andrewrichardr/MSE3380BGearBoxProject/Figures/ShaftB_torque_diagram.png

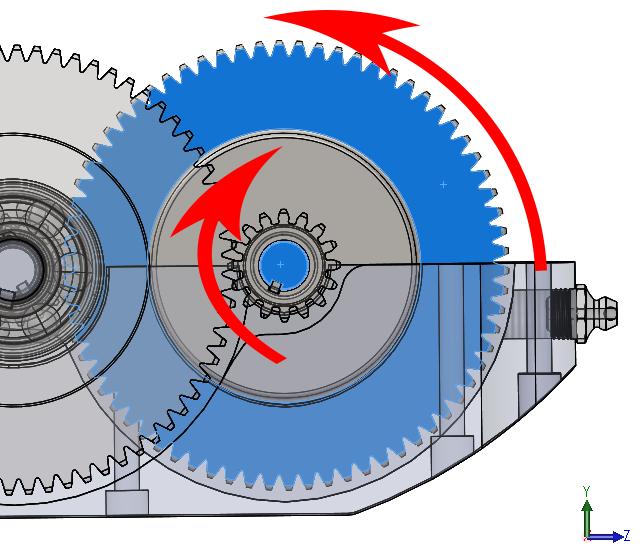
Figures/ShaftB_torque_diagram.png
