andrewrichardr/MSE3380BGearBoxProject/Figures/ShaftC_torque_diagram.png

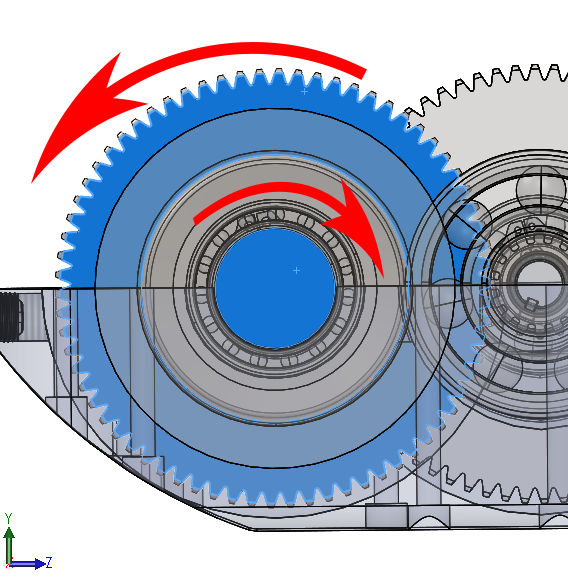
Figures/ShaftC_torque_diagram.png
