andrewrichardr/MSE3380BGearBoxProject/CAD/Drawing.PNG

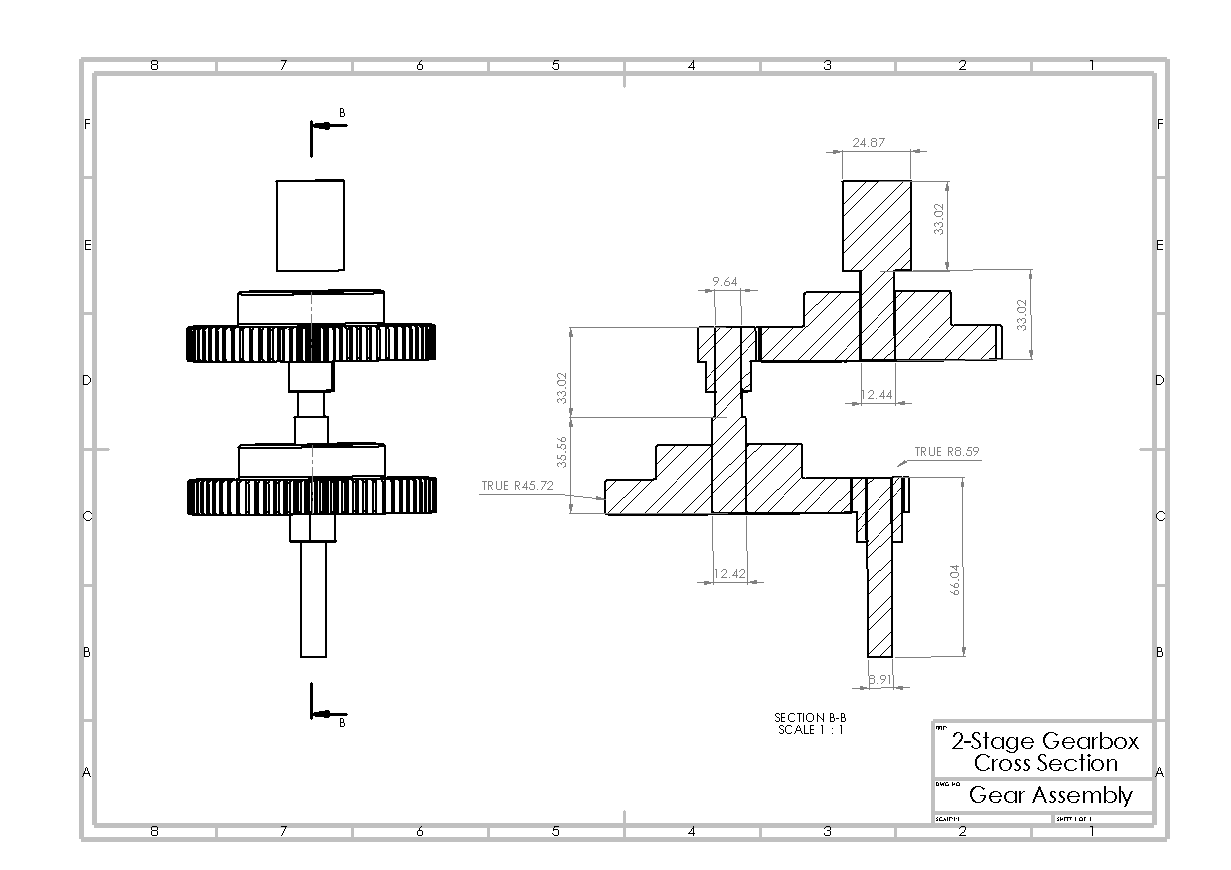
CAD/Drawing.PNG
