andrewrichardr/MSE3380BGearBoxProject/CAD/Part Drawings/Gear_Final.png

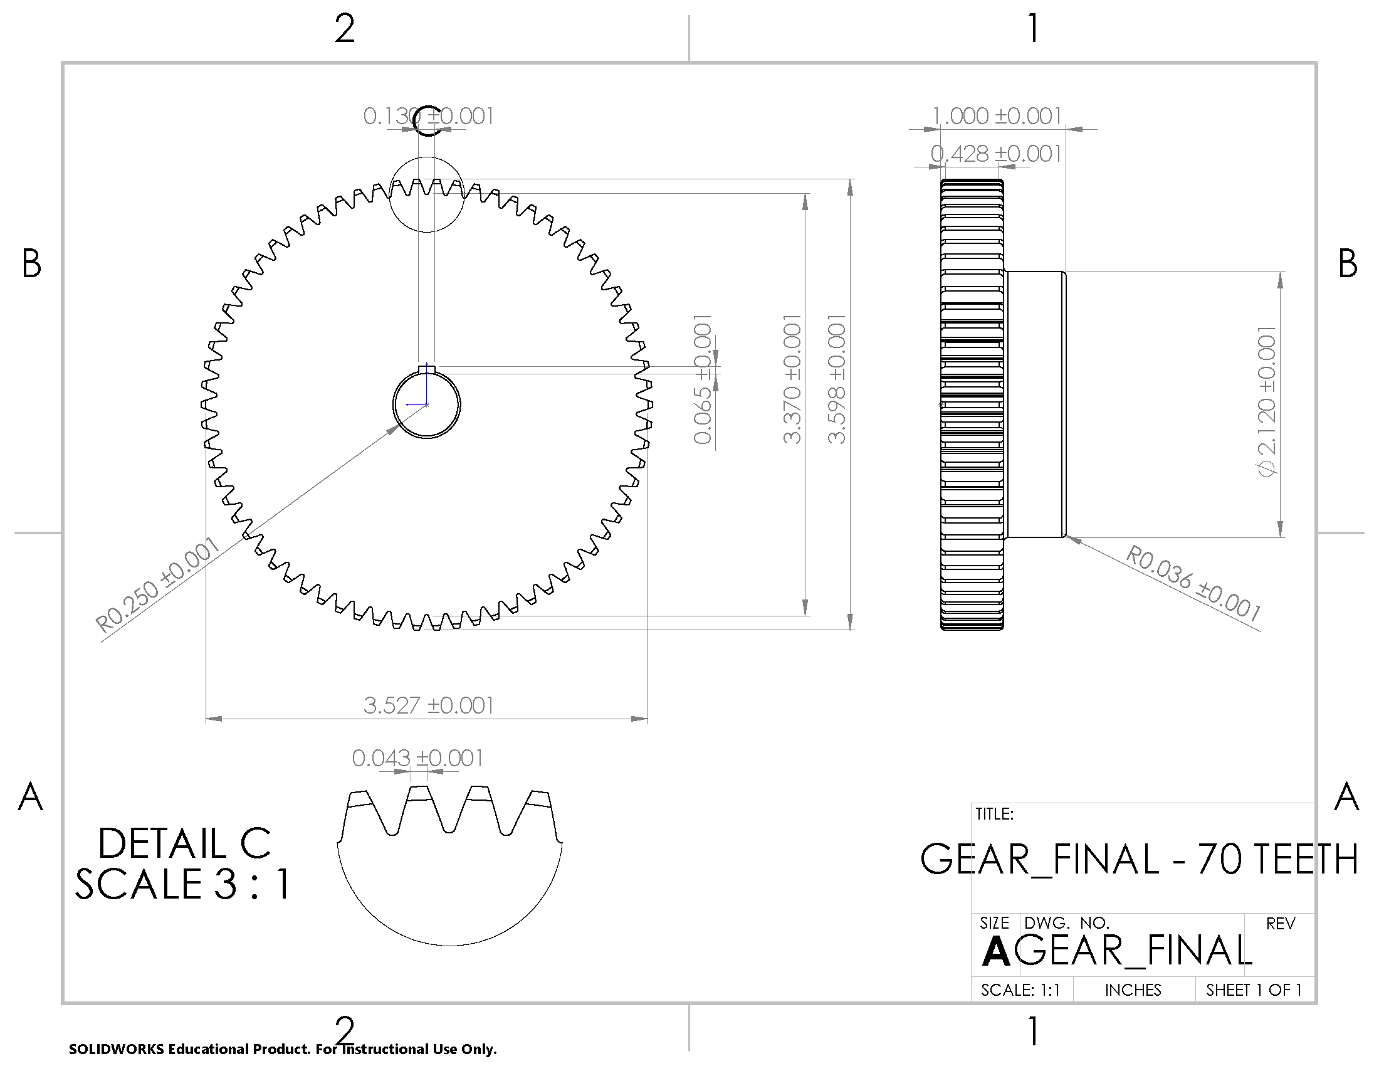
CAD/Part Drawings/Gear_Final.png
