andrewrichardr/MSE3380BGearBoxProject/CAD/Part Drawings/Pinion_Final.png

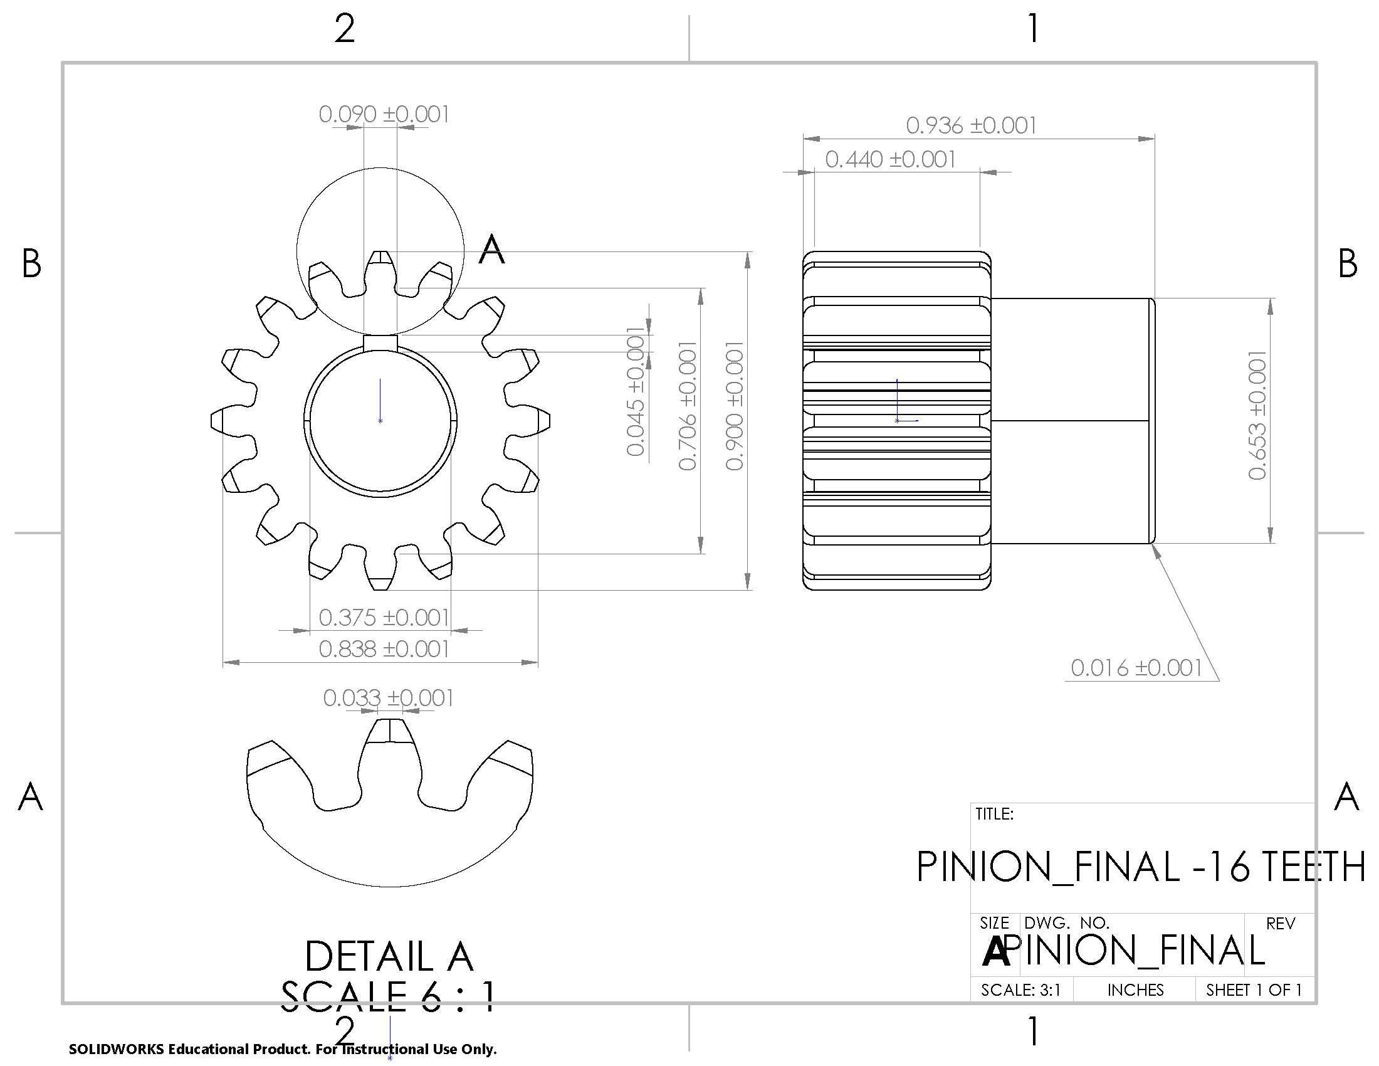
CAD/Part Drawings/Pinion_Final.png
