andrewrichardr/MSE3380BGearBoxProject/CAD/Part Drawings/shaft_A.png

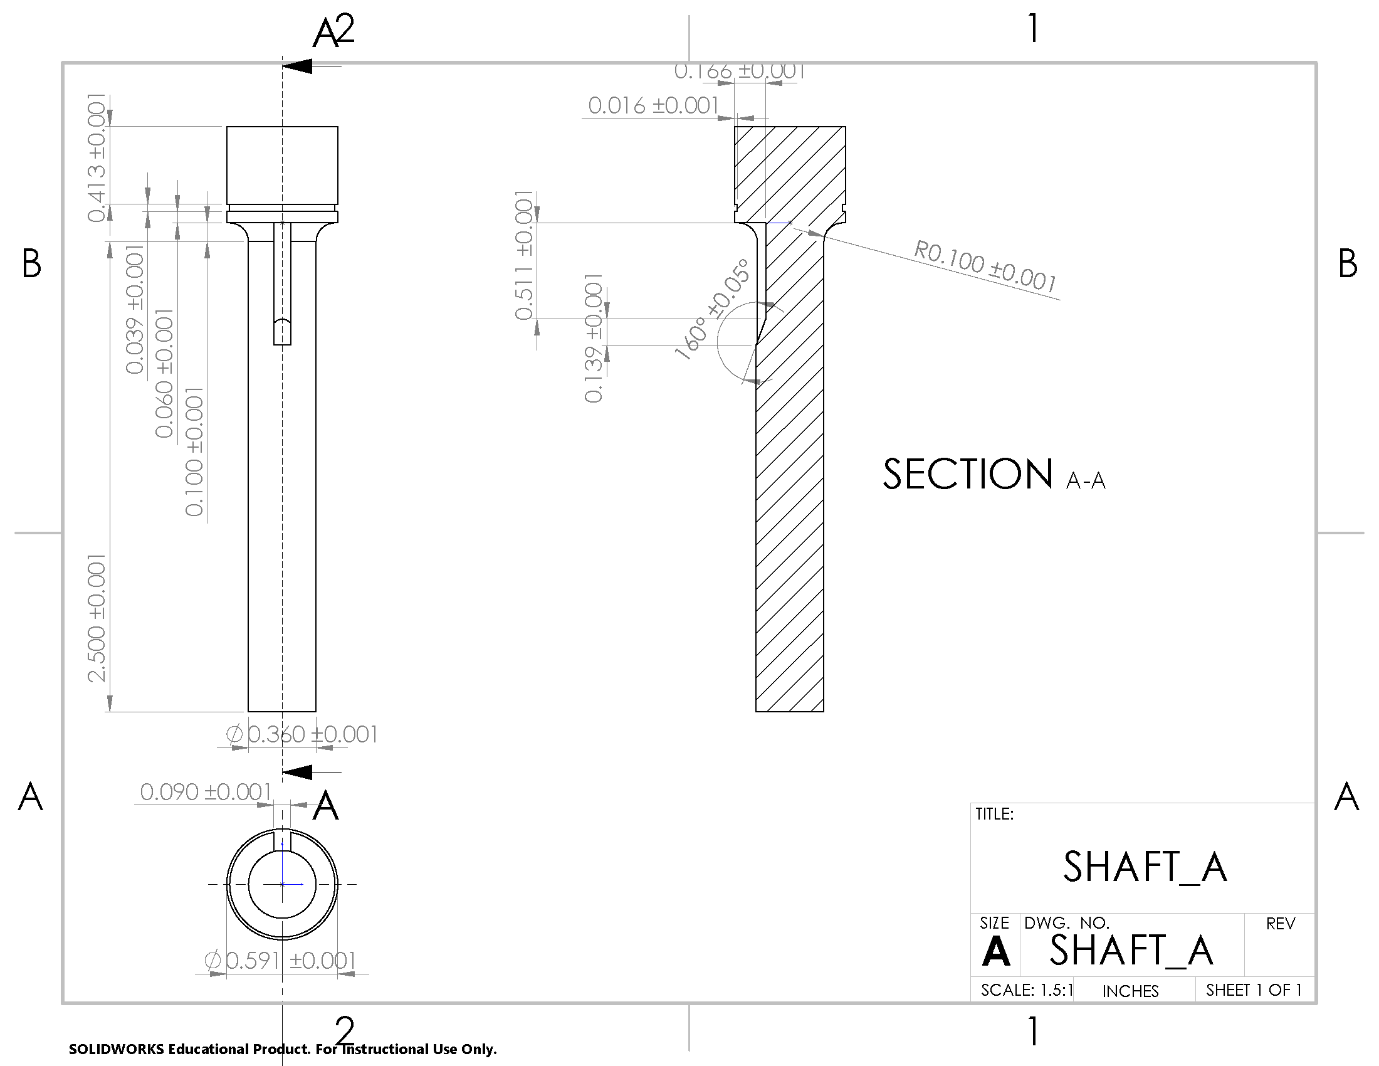
CAD/Part Drawings/shaft_A.png
