andrewrichardr/MSE3380BGearBoxProject/CAD/Part Drawings/shaft_B.png

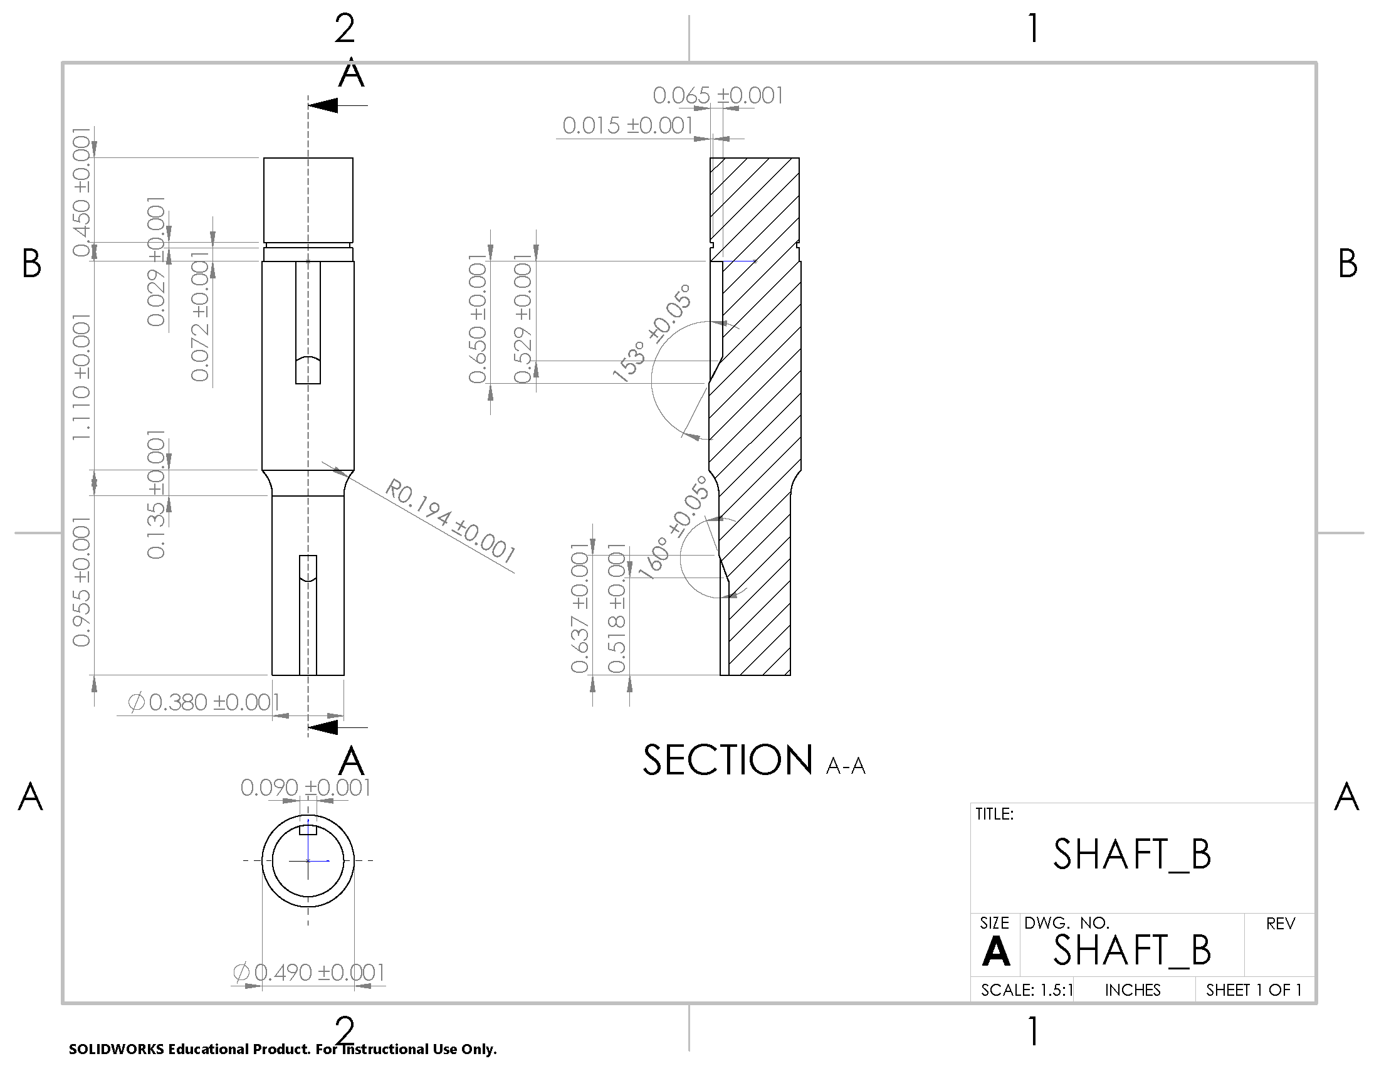
CAD/Part Drawings/shaft_B.png
