andrewrichardr/MSE3380BGearBoxProject/CAD/Part Drawings/Shaft_C.png

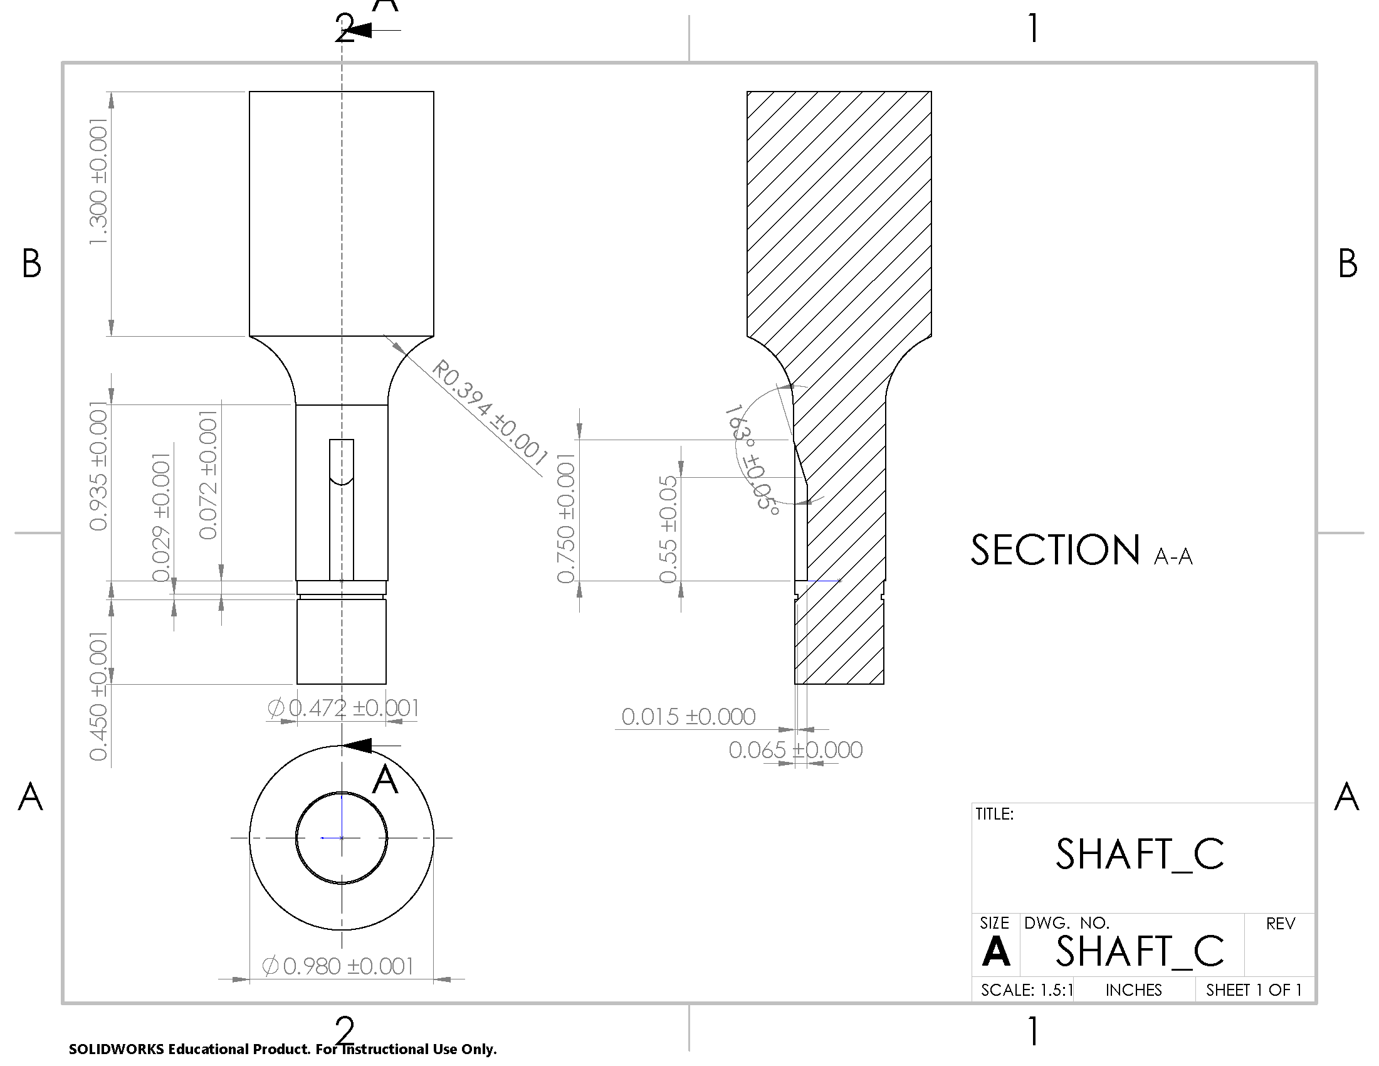
CAD/Part Drawings/Shaft_C.png
