andrewrichardr/MSE3380BGearBoxProject/CAD/retaining rings/groove4.PNG

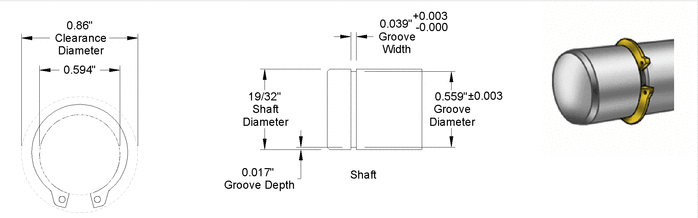
CAD/retaining rings/groove4.PNG
