andrewrichardr/MSE3380BGearBoxProject/CAD/retaining rings/groove13.PNG

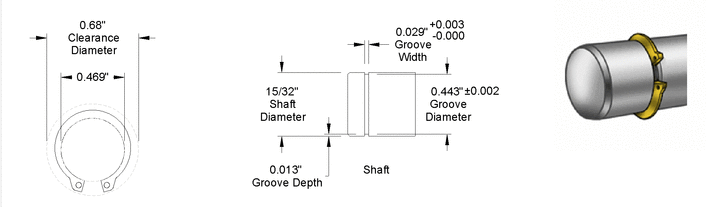
CAD/retaining rings/groove13.PNG
