andrewrichardr/MSE3380BGearBoxProject/Figures/Interim/3D_Model_Placeholder.png

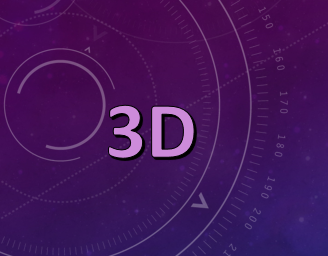
Figures/Interim/3D_Model_Placeholder.png
