andrewrichardr/MSE3380BGearBoxProject/Figures/Interim/contactForces.jpg

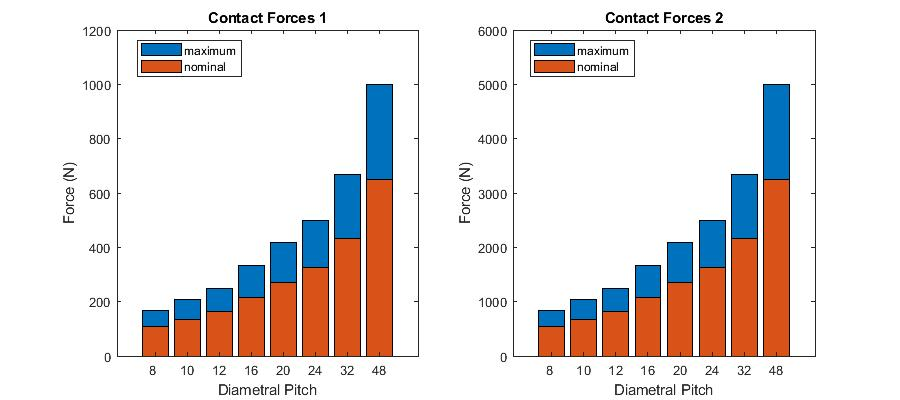
Figures/Interim/contactForces.jpg
