andrewrichardr/MSE3380BGearBoxProject/Figures/Interim/drawings.png

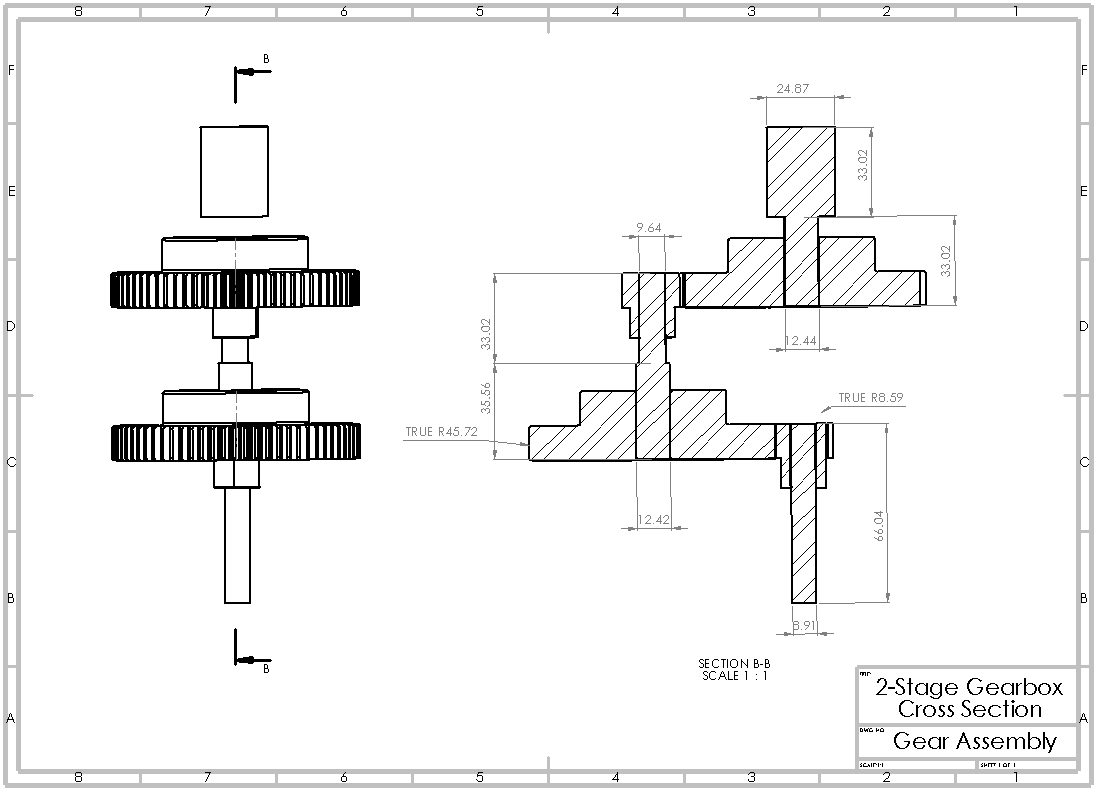
Figures/Interim/drawings.png
