andrewrichardr/MSE3380BGearBoxProject/Figures/Interim/fbd_pinion2_gear2.PNG

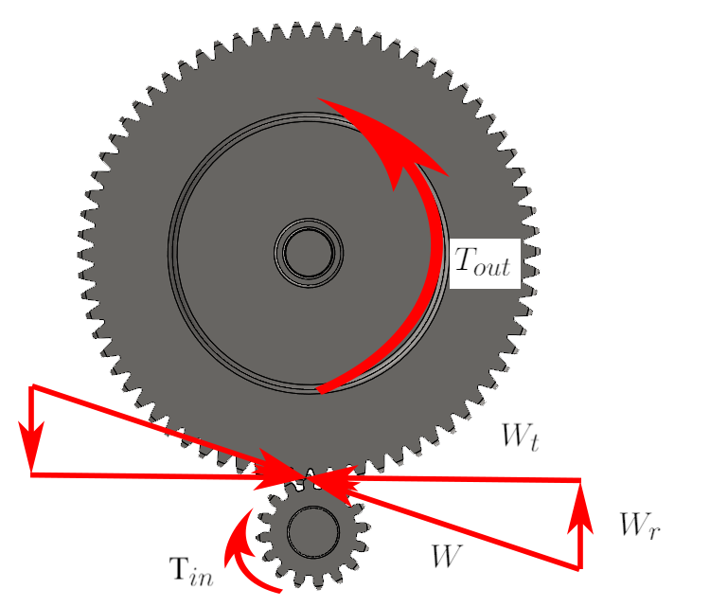
Figures/Interim/fbd_pinion2_gear2.PNG
