andrewrichardr/MSE3380BGearBoxProject/Figures/Interim/Gear.png

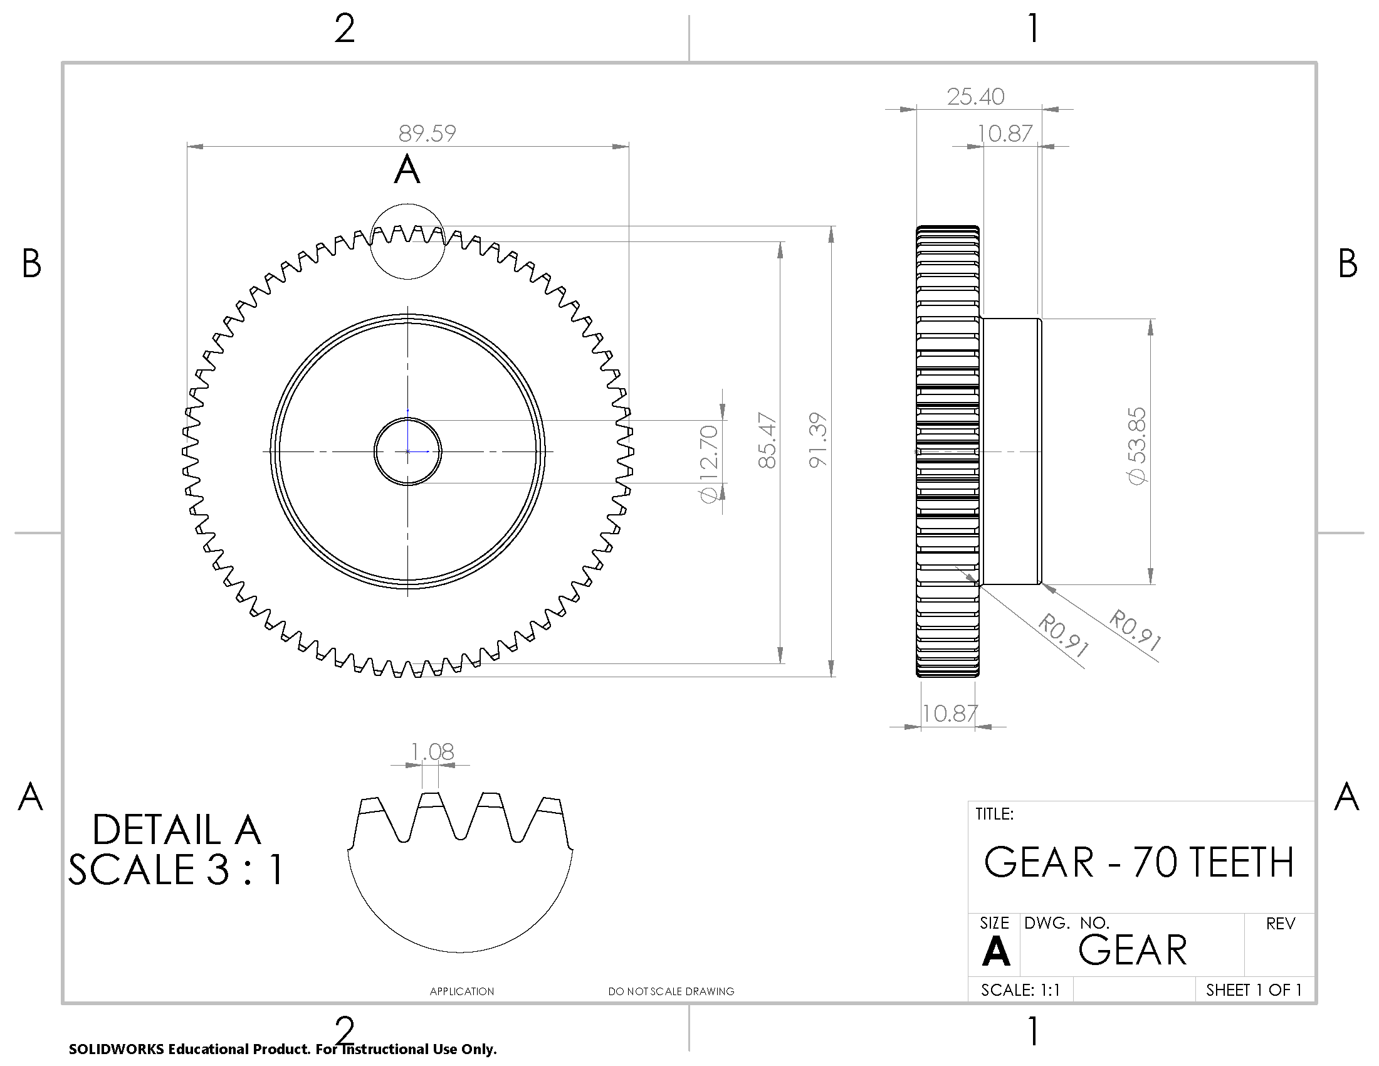
Figures/Interim/Gear.png
