andrewrichardr/MSE3380BGearBoxProject/Figures/Interim/gear_pinion_forces_2d-Recovered.png

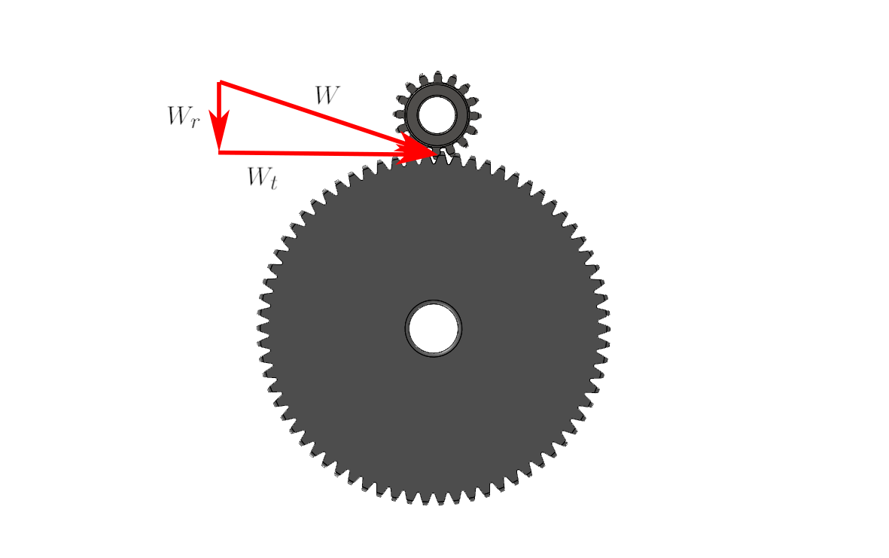
Figures/Interim/gear_pinion_forces_2d-Recovered.png
