andrewrichardr/MSE3380BGearBoxProject/Figures/Interim/gearbox.png

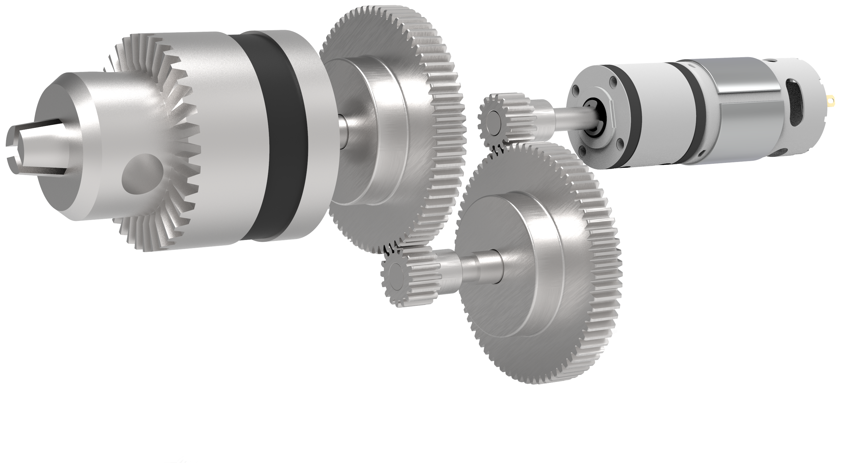
Figures/Interim/gearbox.png
