andrewrichardr/MSE3380BGearBoxProject/Figures/Interim/Pinion.png

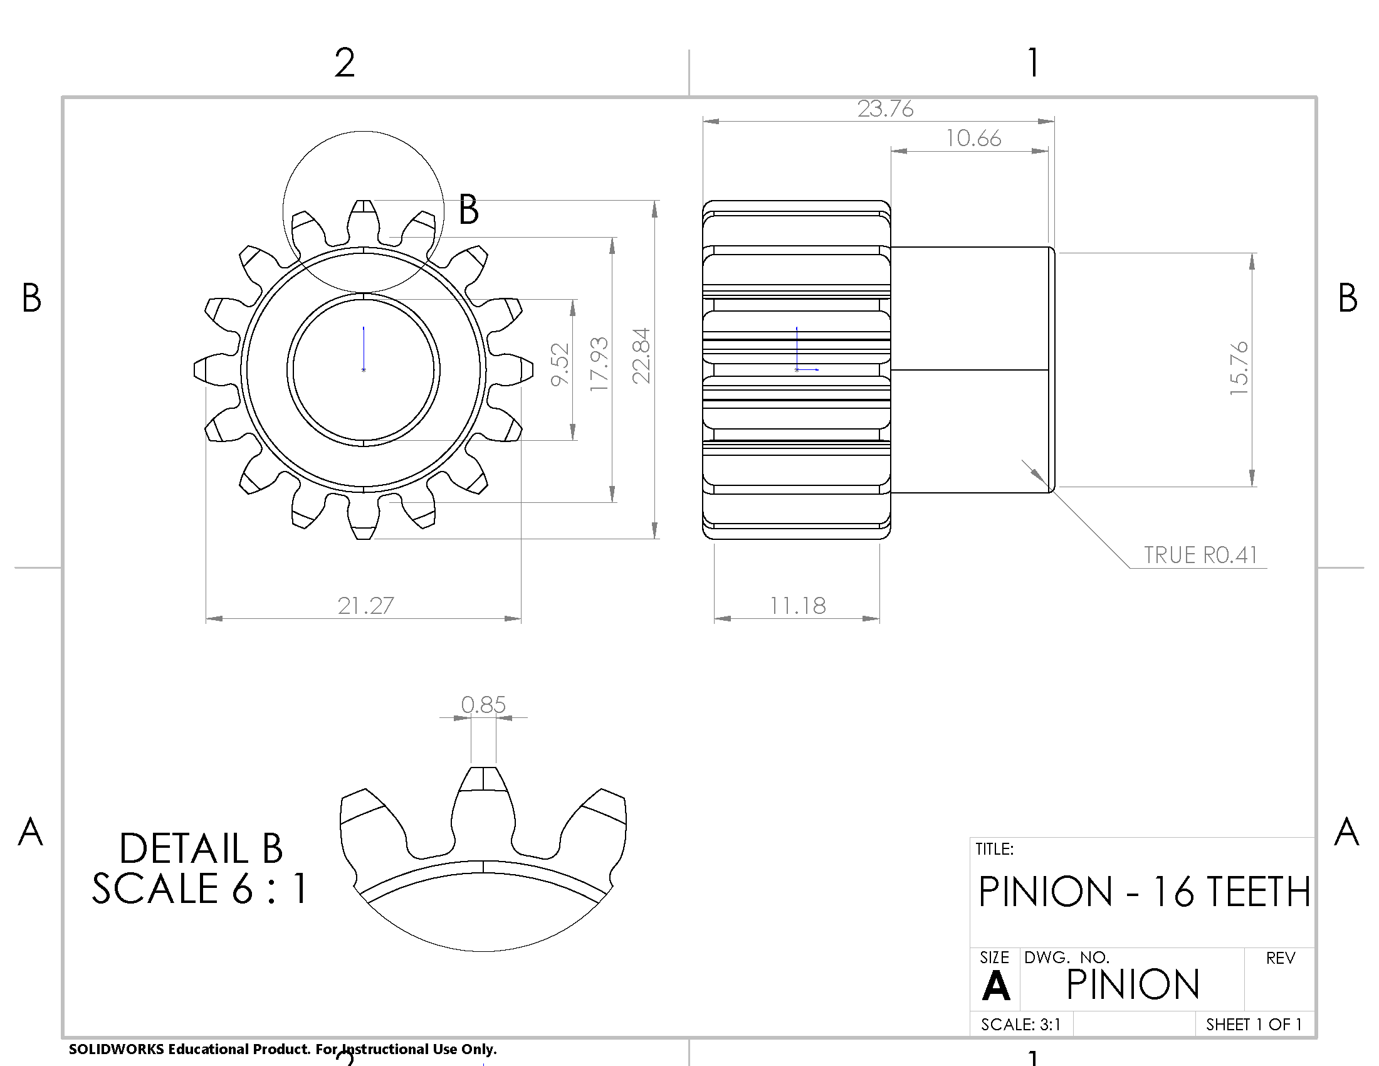
Figures/Interim/Pinion.png
