andrewrichardr/MSE3380BGearBoxProject/Figures/Interim/torque.jpg

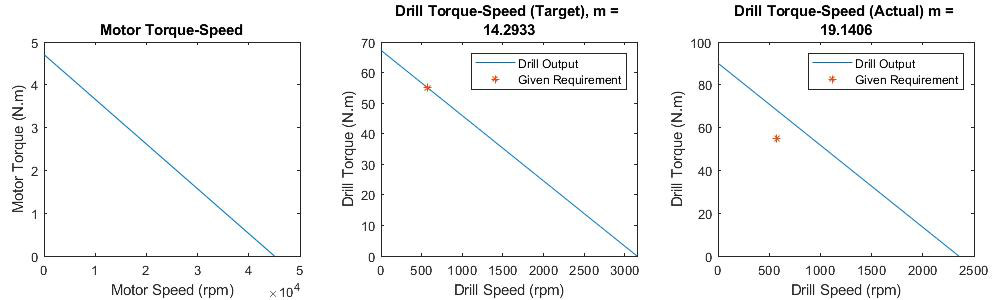
Figures/Interim/torque.jpg
