andrewrichardr/MSE3380BGearBoxProject/Figures/Interim/TorqueSpeed.jpg

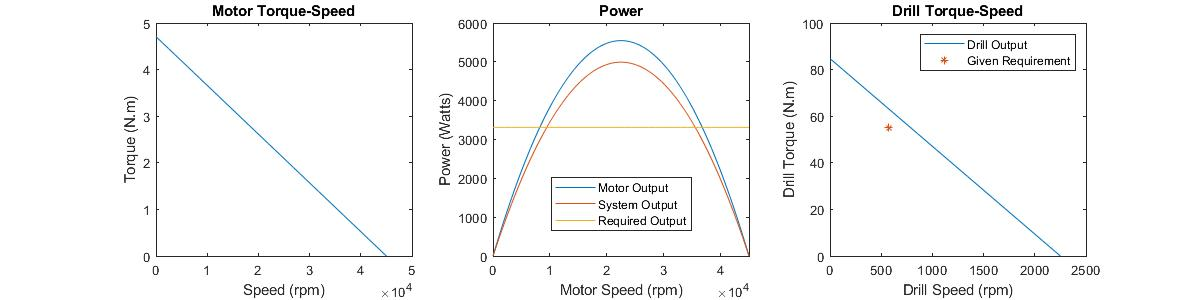
Figures/Interim/TorqueSpeed.jpg
