andrewrichardr/MSE3380BGearBoxProject/Figures/SBT_A.jpg

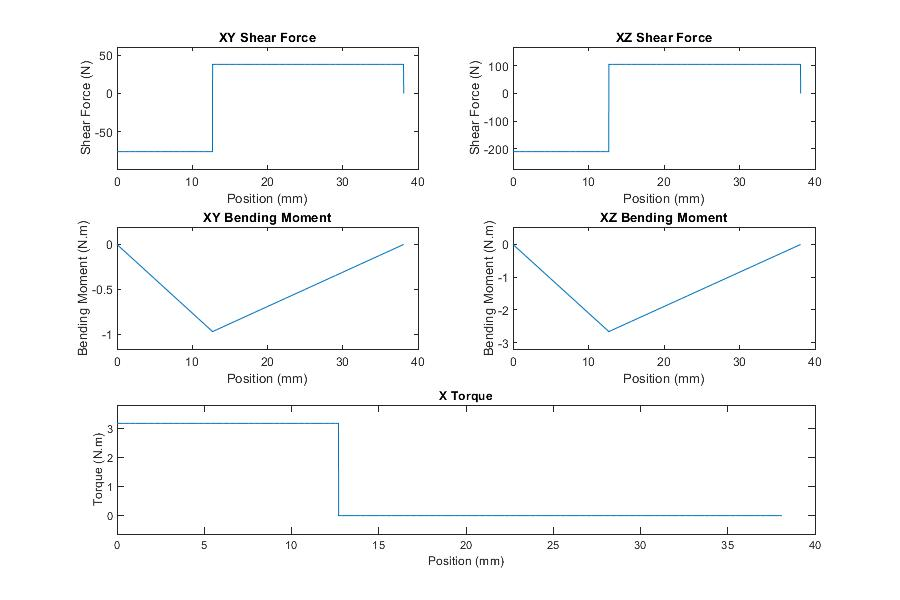
Figures/SBT_A.jpg
