andrewrichardr/MSE3380BGearBoxProject/Figures/SBT_C.jpg

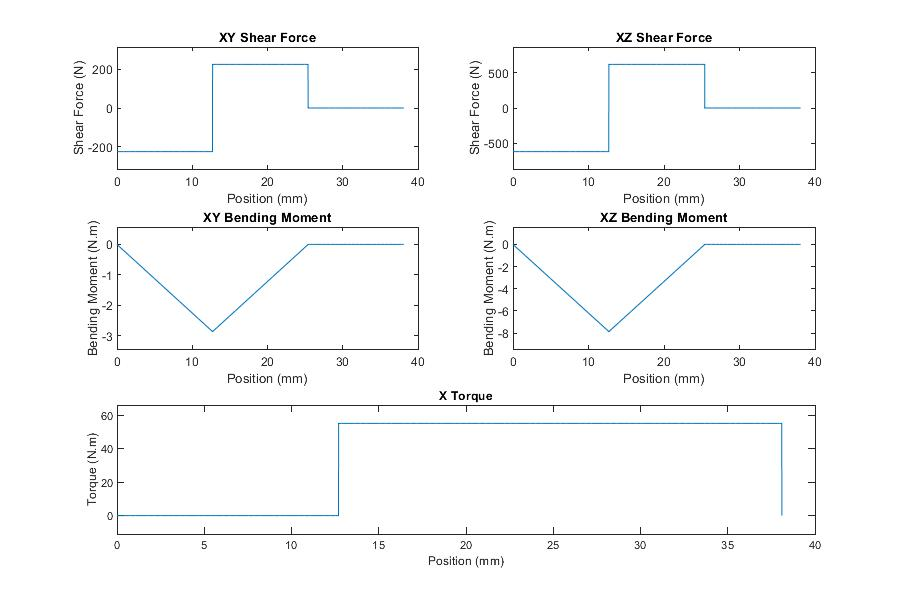
Figures/SBT_C.jpg
