andrewrichardr/MSE3380BGearBoxProject/Figures/ShaftA_clear.PNG

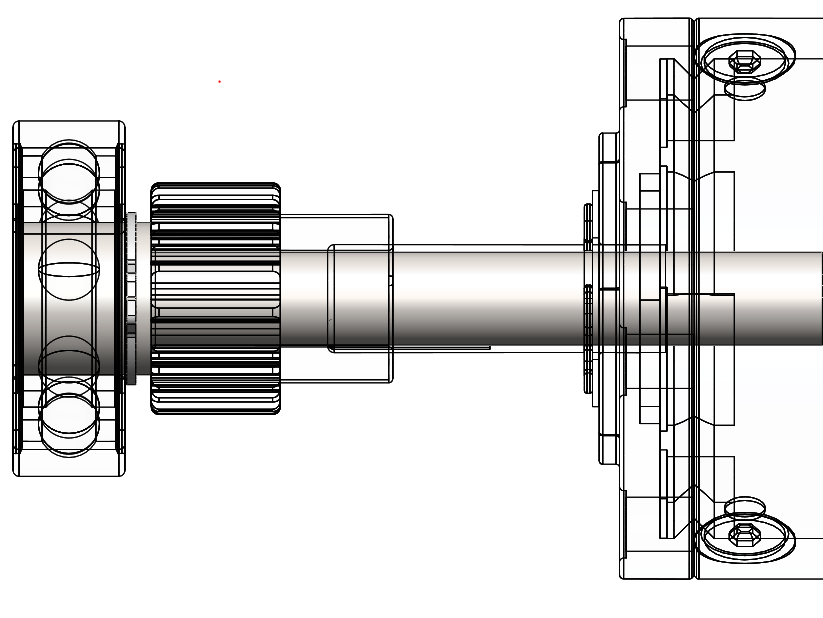
Figures/ShaftA_clear.PNG
