andrewrichardr/MSE3380BGearBoxProject/Figures/ShaftA_torque_diagram.png

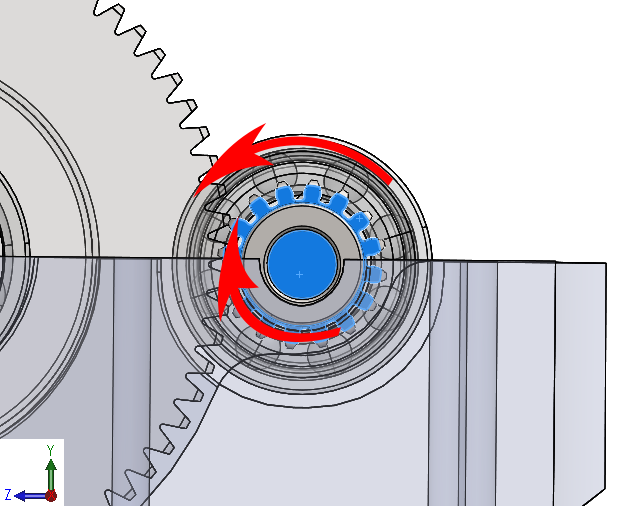
Figures/ShaftA_torque_diagram.png
