andrewrichardr/MSE3380BGearBoxProject/Figures/ShaftA_XY_FBD.png

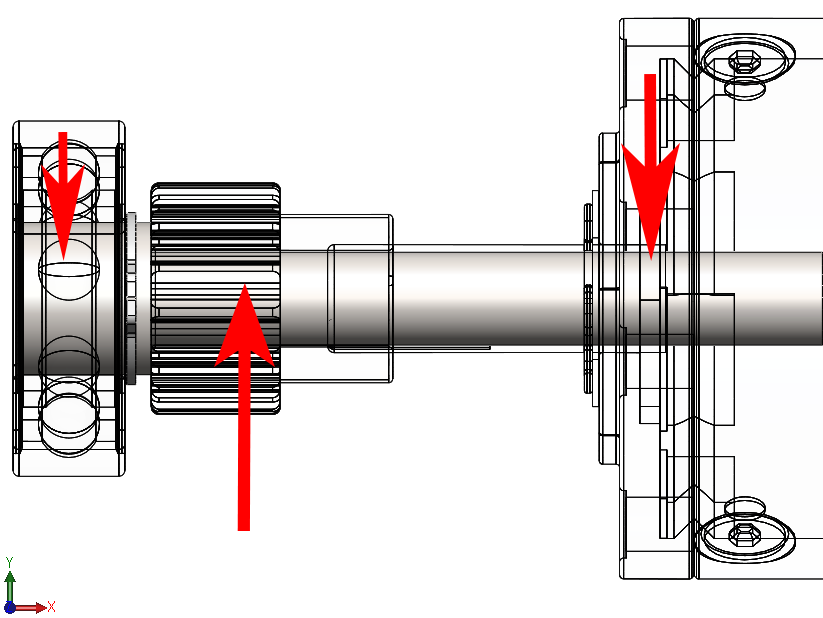
Figures/ShaftA_XY_FBD.png
