andrewrichardr/MSE3380BGearBoxProject/Figures/ShaftB_clear.PNG

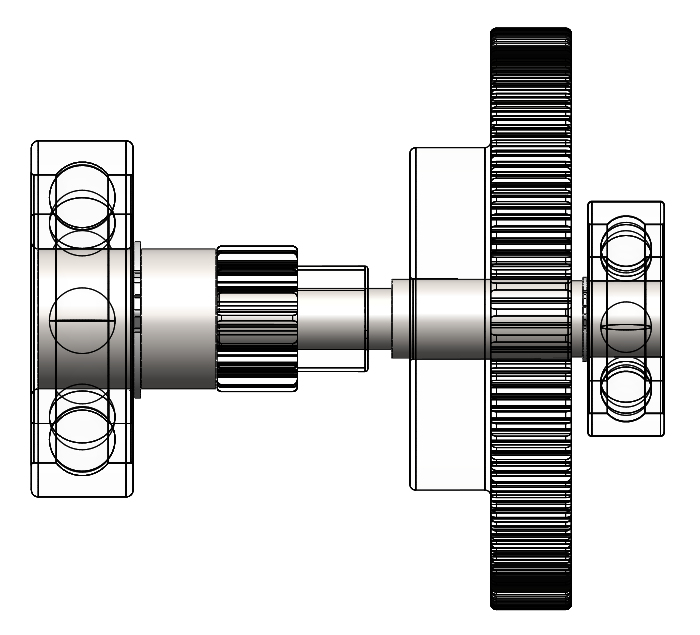
Figures/ShaftB_clear.PNG
