andrewrichardr/MSE3380BGearBoxProject/Figures/ShaftB_torque_diagram_clean.PNG

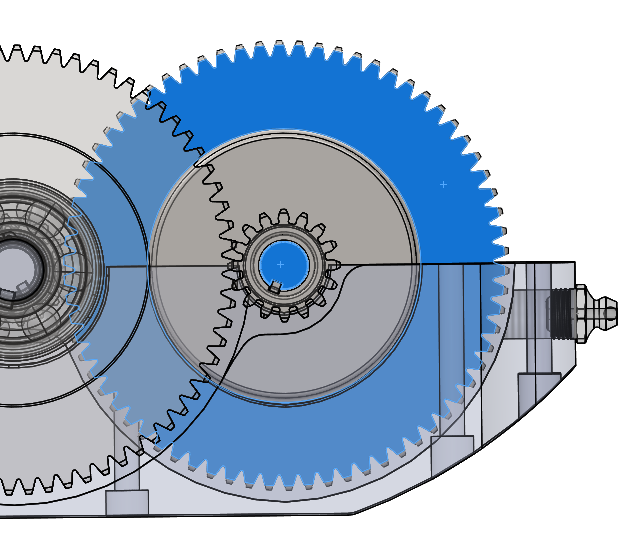
Figures/ShaftB_torque_diagram_clean.PNG
