andrewrichardr/MSE3380BGearBoxProject/Figures/ShaftB_XY_FBD.png

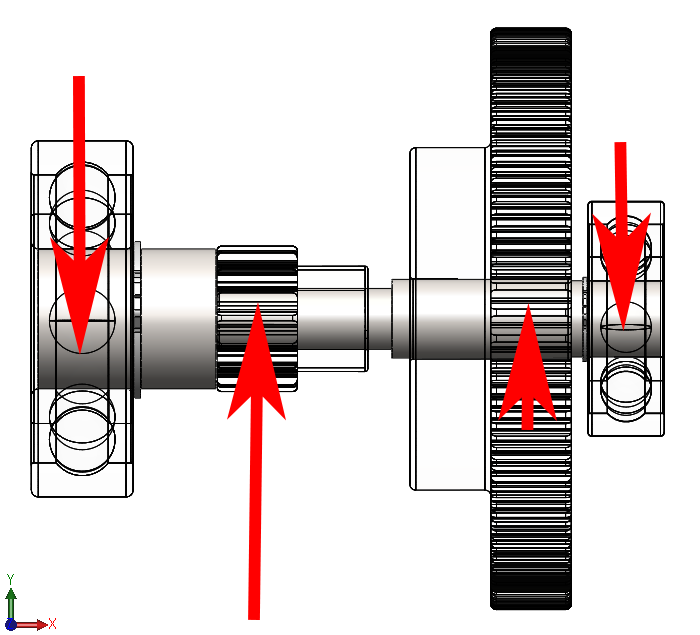
Figures/ShaftB_XY_FBD.png
