andrewrichardr/MSE3380BGearBoxProject/Figures/ShaftC_clear.PNG

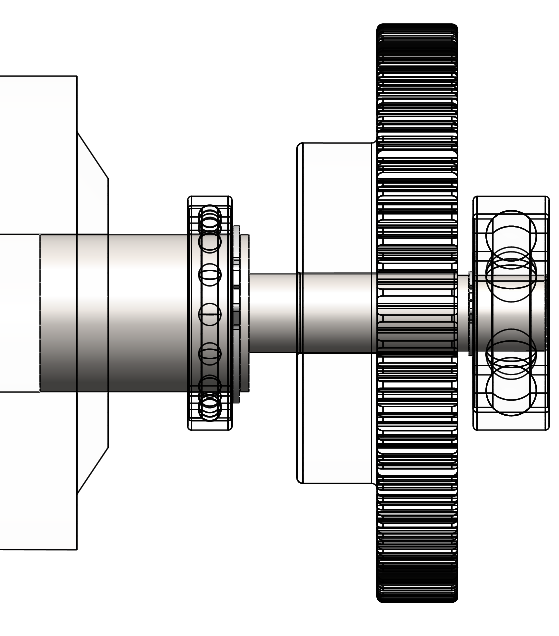
Figures/ShaftC_clear.PNG
