andrewrichardr/MSE3380BGearBoxProject/CAD/AssemblyWithMotor/6301.sldasm

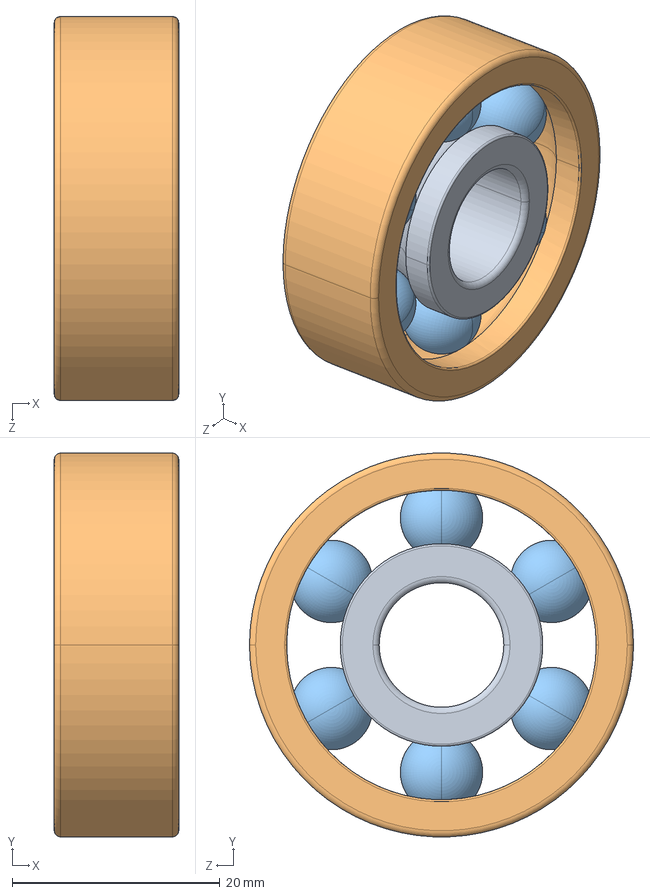
[picture p39: CAD file, 2019-04-09]
CAD/AssemblyWithMotor/6301.sldasm
12.0 x 37.0 x 37.0 mm
_6301_PART1_2
_6301_PART2_4
_6301_PART3_6 x 6
