andrewrichardr/MSE3380BGearBoxProject/CAD/AssemblyWithMotor/AssemblyWithMotor.SLDASM

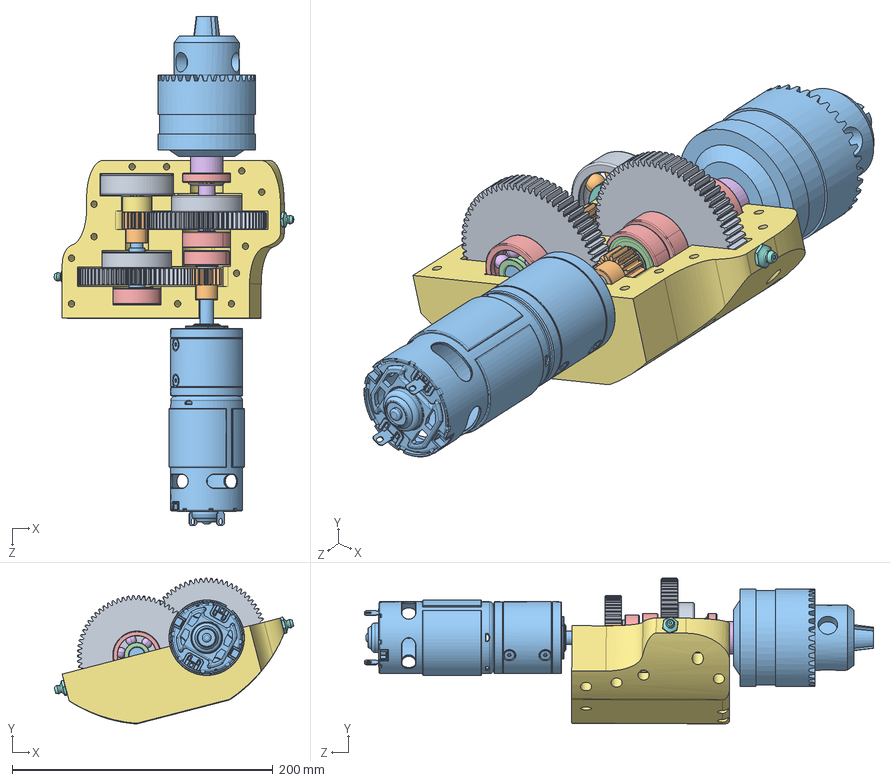
[picture p40: CAD file, 2019-04-09]
CAD/AssemblyWithMotor/AssemblyWithMotor.SLDASM
183.6 x 111.8 x 390.2 mm
Gear x 2
Pinion x 2
Chuck
_6202_2RSL_PART1_2
_6202_2RSL_PART2_4
_6202_2RSL_PART3_6 x 8
bearingshaft3
_63_22_PART1_2
_63_22_PART2_4
_63_22_PART3_6 x 7
bearingshaft4
_6301_PART1_2 x 2
_6301_PART2_4 x 2
_6301_PART3_6 x 12
housing
Bearing13 x 2
Bearing2
bearing4
motorDC
_61805_PART1_2
_61805_PART2_4
_61805_PART3_6 x 15
NEWRING
1095K650_STEEL GREASE FITTING x 2
shaft_A
keyway_A
shaft_B
keyway_B1
keyway_B2
Shaft_C
keyway_C
