andrewrichardr/MSE3380BGearBoxProject/CAD/Parts/motorDC.SLDASM

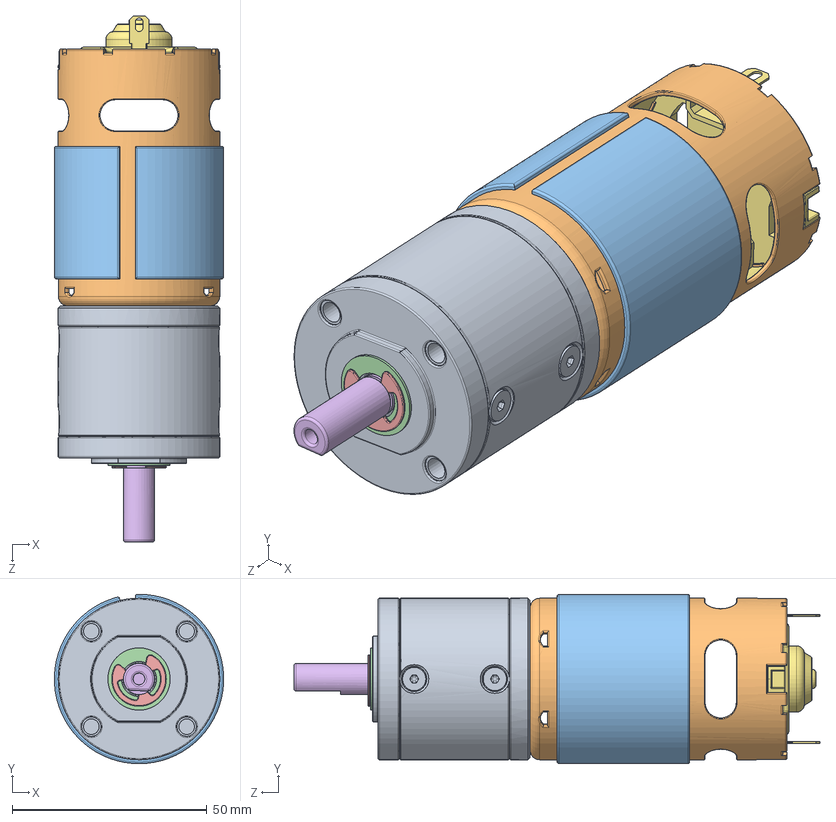
[picture p41: CAD file, 2019-03-22]
CAD/Parts/motorDC.SLDASM
43.5 x 43.5 x 135.1 mm
GearBox_motorDC
Coil_motorDC
Gelung_motorDC
Wessel_motorDC
Lock_motorDC
Shaft_motorDC
Brush_motorDC
