andrewrichardr/MSE3380BGearBoxProject/CAD/Final_Assembly/housing.SLDPRT

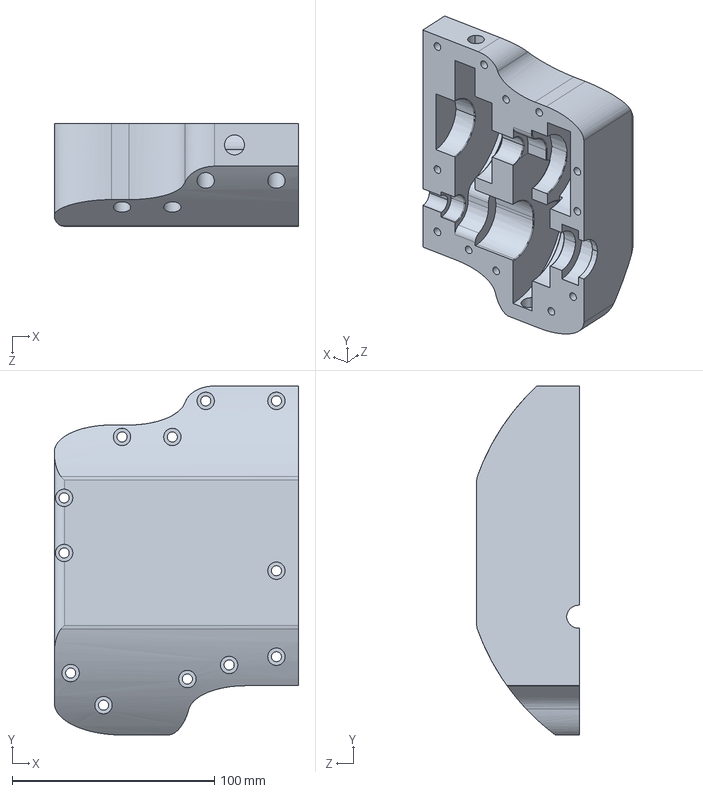
[picture p42: CAD file, 2019-04-09]
CAD/Final_Assembly/housing.SLDPRT
120.9 x 172.7 x 50.8 mm
