andrewrichardr/MSE3380BGearBoxProject/CAD/NEWRING.SLDPRT

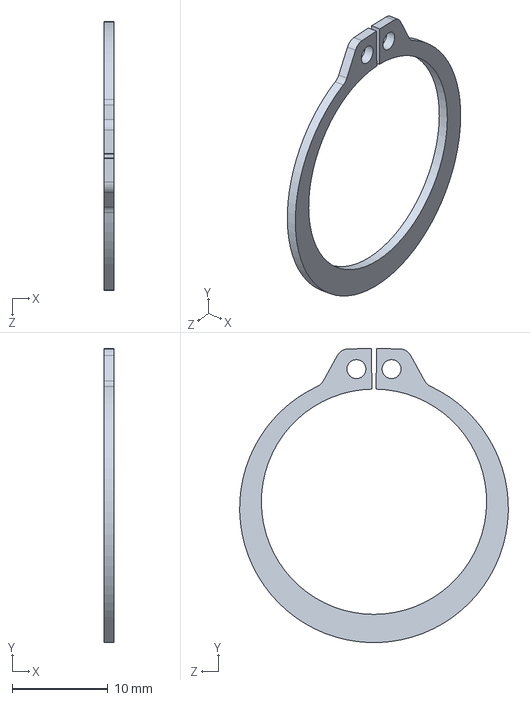
[picture p43: CAD file, 2019-04-09]
CAD/NEWRING.SLDPRT
1.07 x 30.7 x 28.0 mm
