andrewrichardr/MSE3380BGearBoxProject/CAD/Parts/Lock_motorDC.SLDPRT

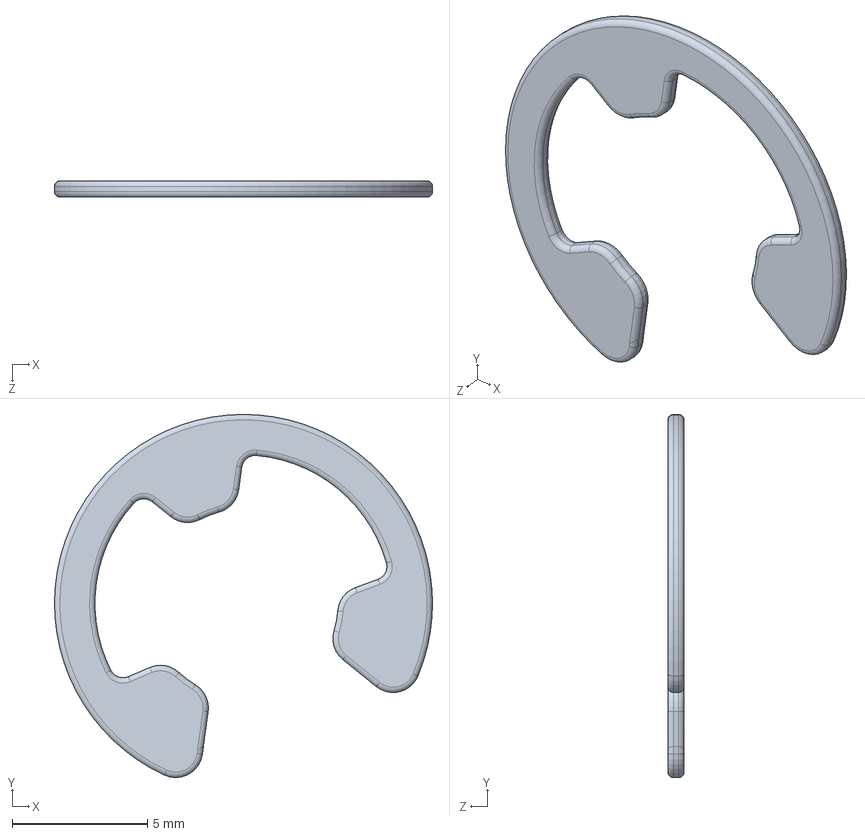
[picture p44: CAD file, 2019-03-22]
CAD/Parts/Lock_motorDC.SLDPRT
14.0 x 13.4 x 0.6 mm
