andrewrichardr/MSE3380BGearBoxProject/CAD/retaining rings/Bearing13.SLDPRT

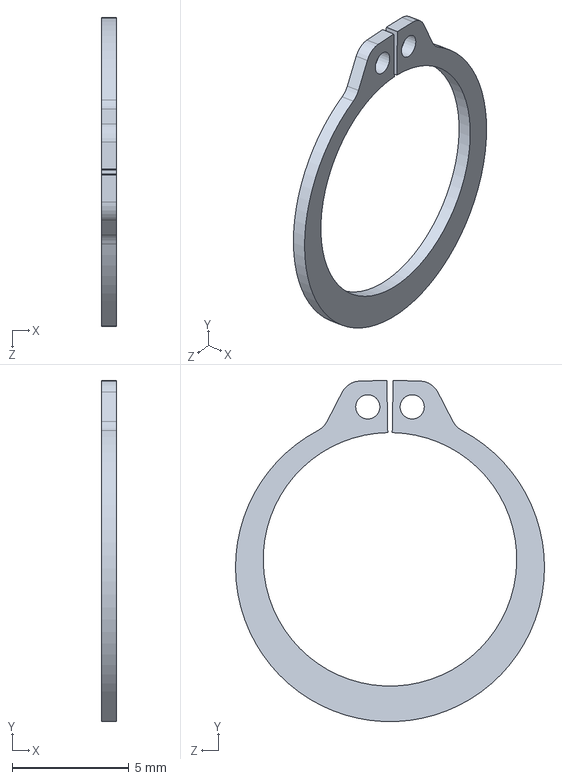
[picture p45: CAD file, 2019-04-08]
CAD/retaining rings/Bearing13.SLDPRT
0.635 x 14.6 x 13.2 mm
