andrewrichardr/MSE3380BGearBoxProject/CAD/Parts/Brush_motorDC.SLDPRT

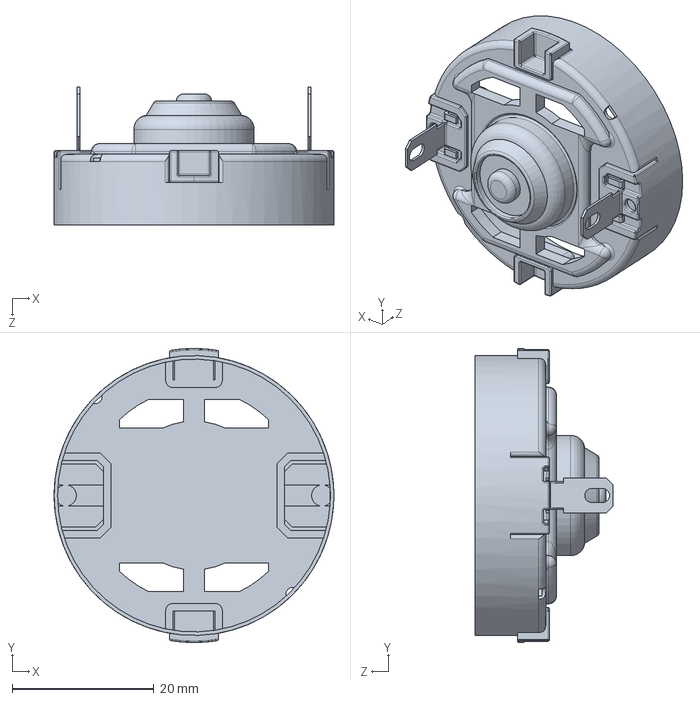
[picture p46: CAD file, 2019-03-22]
CAD/Parts/Brush_motorDC.SLDPRT
39.5 x 41.5 x 19.5 mm
