andrewrichardr/MSE3380BGearBoxProject/CAD/retaining rings/Bearing2.SLDPRT

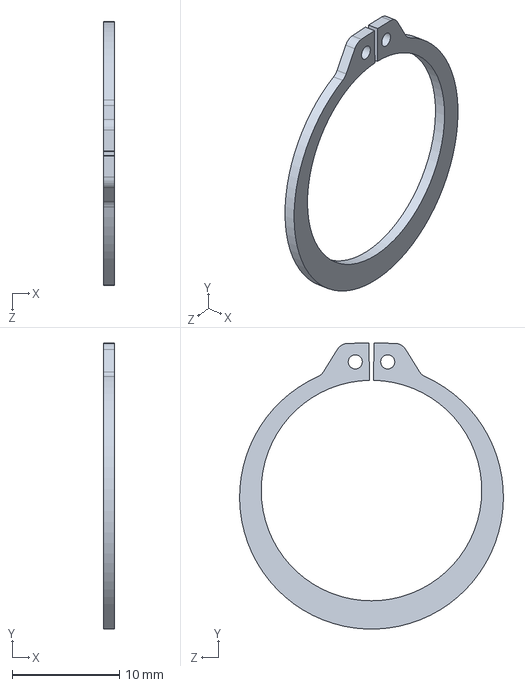
[picture p47: CAD file, 2019-04-08]
CAD/retaining rings/Bearing2.SLDPRT
1.07 x 26.7 x 24.6 mm
