andrewrichardr/MSE3380BGearBoxProject/CAD/Parts/Chuck_Shaft.SLDPRT

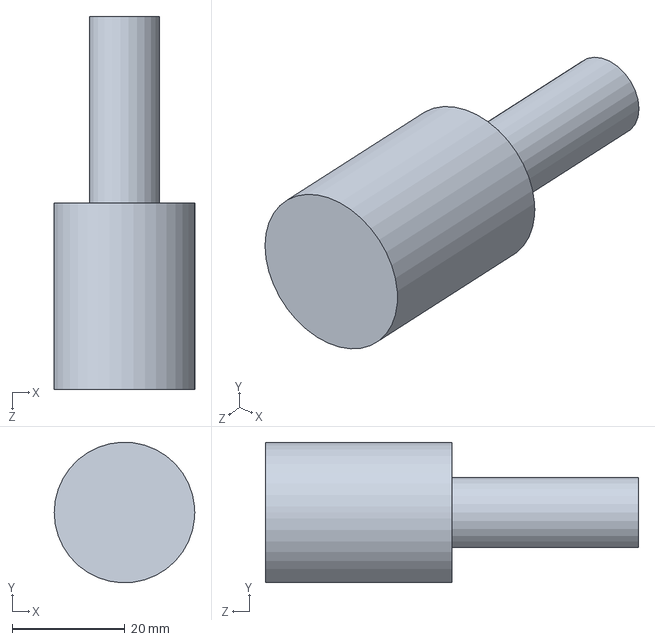
[picture p48: CAD file, 2019-03-22]
CAD/Parts/Chuck_Shaft.SLDPRT
24.9 x 24.9 x 66.0 mm
