andrewrichardr/MSE3380BGearBoxProject/CAD/retaining rings/bearing4.SLDPRT

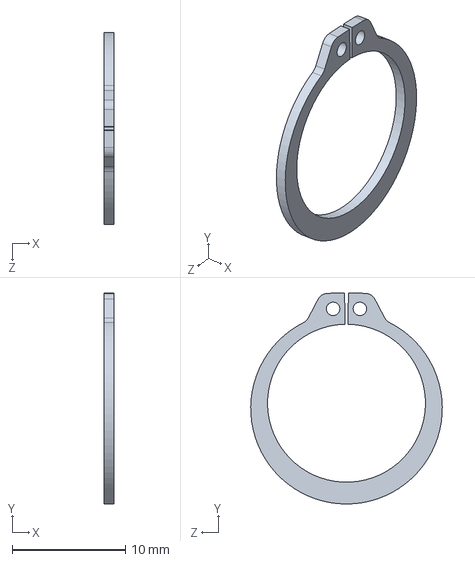
[picture p49: CAD file, 2019-04-08]
CAD/retaining rings/bearing4.SLDPRT
0.889 x 18.7 x 16.9 mm
