andrewrichardr/MSE3380BGearBoxProject/CAD/Final_Assembly/shaft_A.SLDPRT

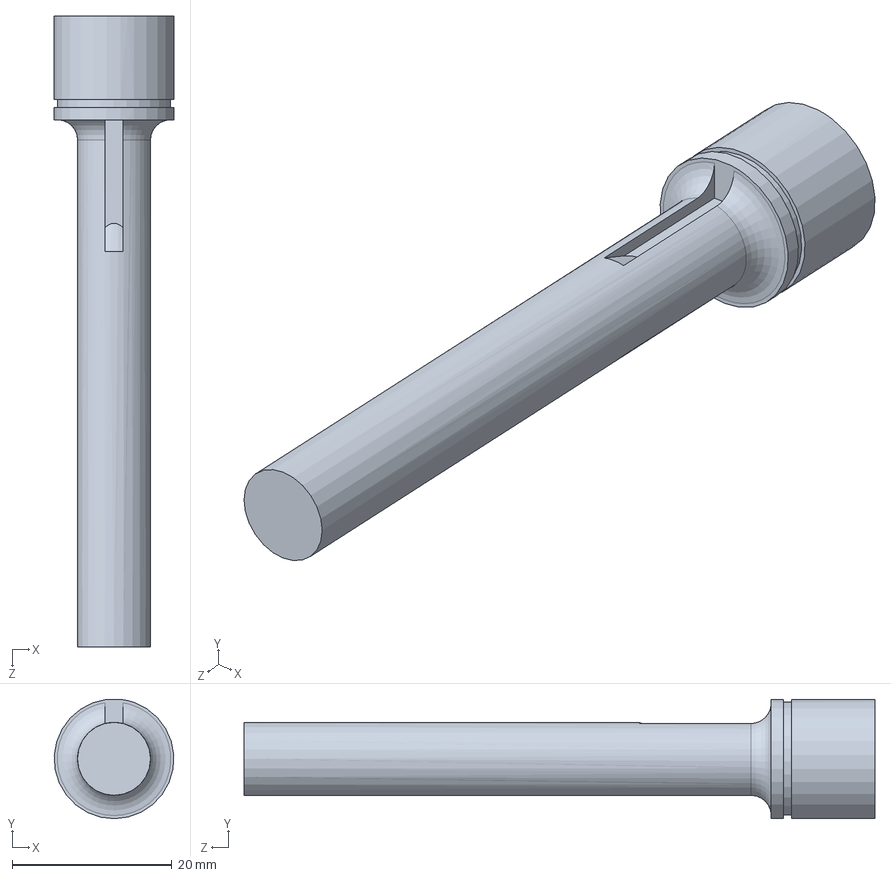
[picture p50: CAD file, 2019-04-09]
CAD/Final_Assembly/shaft_A.SLDPRT
15.0 x 15.0 x 79.0 mm
