andrewrichardr/MSE3380BGearBoxProject/CAD/Parts/Pinion.SLDPRT

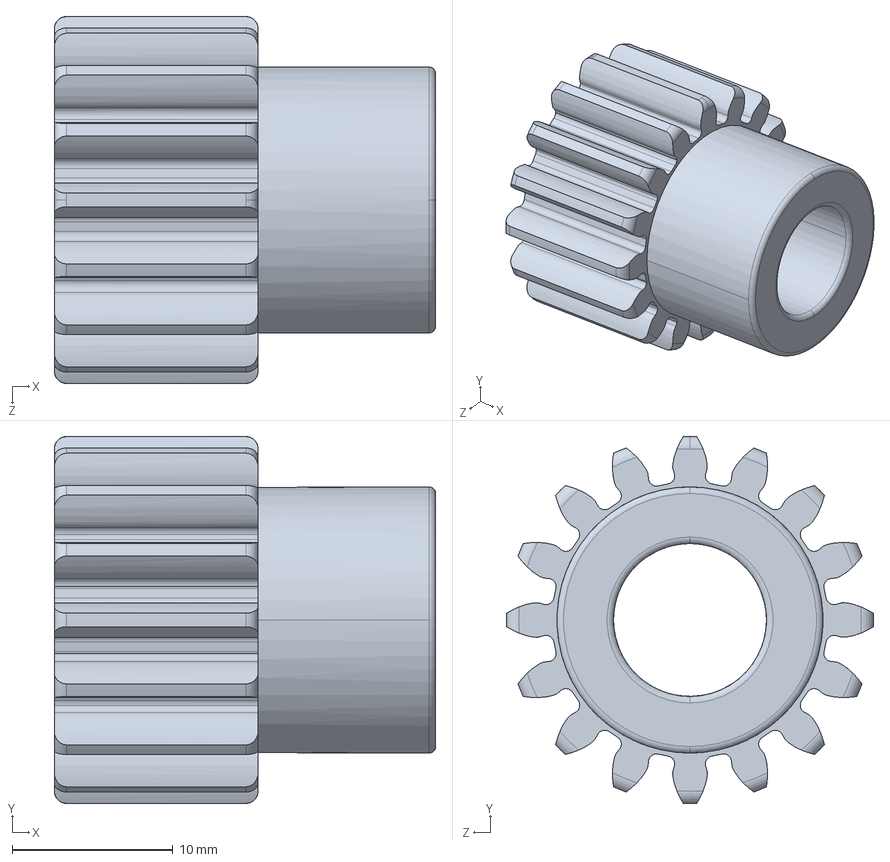
[picture p51: CAD file, 2019-03-22]
CAD/Parts/Pinion.SLDPRT
23.8 x 22.9 x 22.9 mm
