andrewrichardr/MSE3380BGearBoxProject/CAD/AssemblyWithMotor/shaft_B.SLDPRT

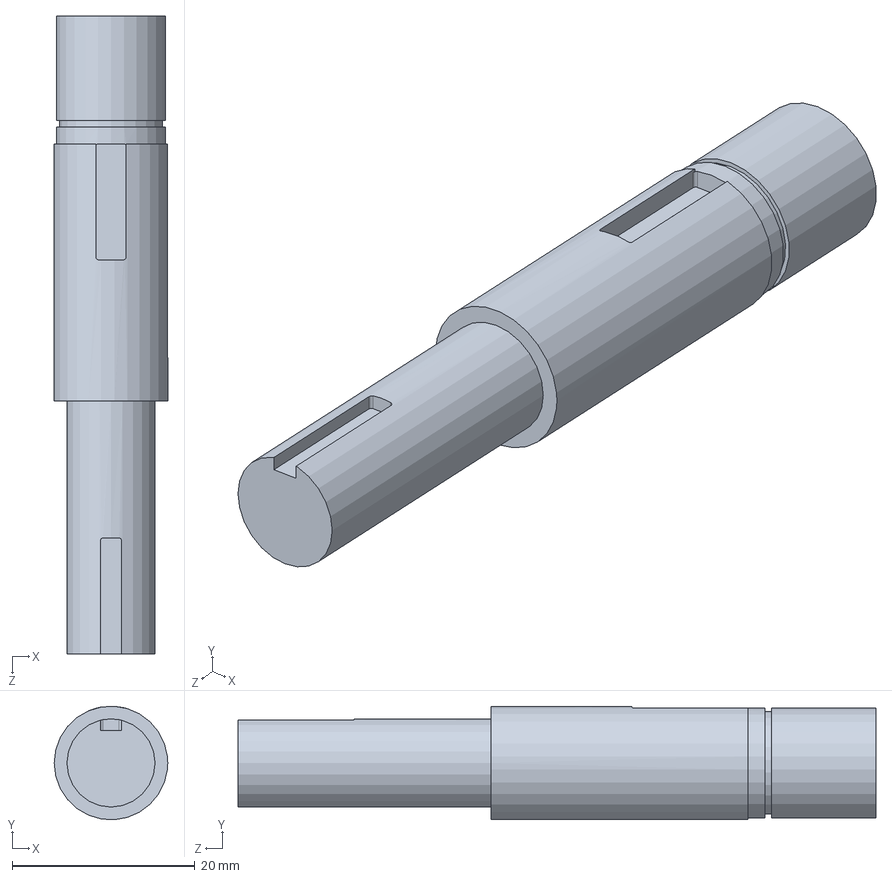
[picture p52: CAD file, 2019-04-09]
CAD/AssemblyWithMotor/shaft_B.SLDPRT
12.4 x 12.4 x 69.9 mm
