andrewrichardr/MSE3380BGearBoxProject/CAD/Final_Assembly/Shaft_C.SLDPRT

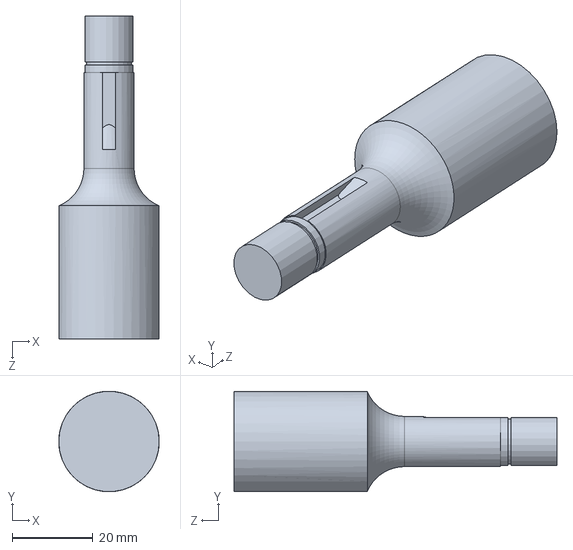
[picture p53: CAD file, 2019-04-09]
CAD/Final_Assembly/Shaft_C.SLDPRT
24.9 x 24.9 x 80.0 mm
