andrewrichardr/MSE3380BGearBoxProject/CAD/Parts/Pinion_Shaft.SLDPRT

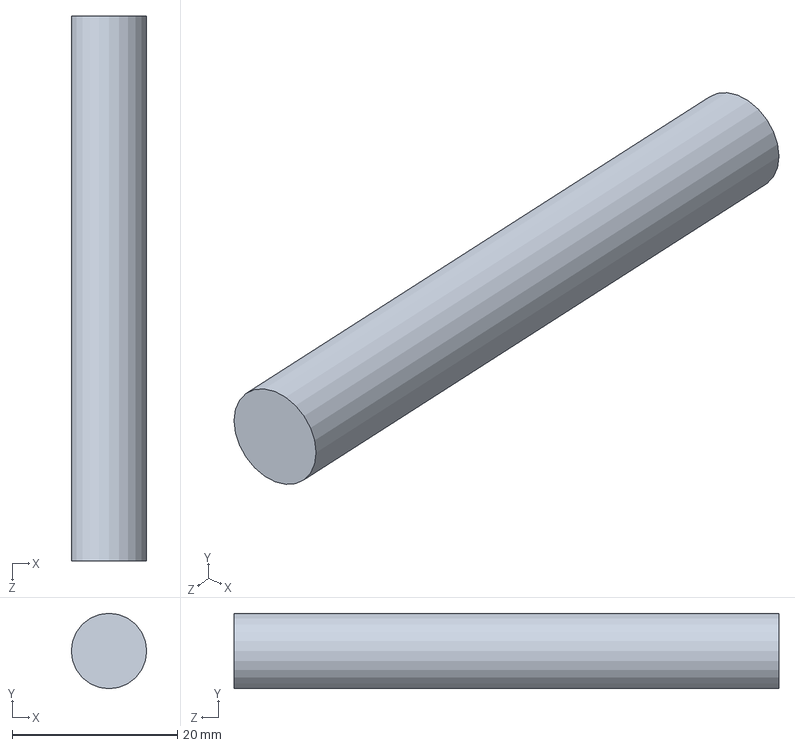
[picture p54: CAD file, 2019-03-22]
CAD/Parts/Pinion_Shaft.SLDPRT
9.14 x 9.14 x 66.0 mm
