andrewrichardr/MSE3380BGearBoxProject/CAD/Parts/Gelung_motorDC.SLDPRT

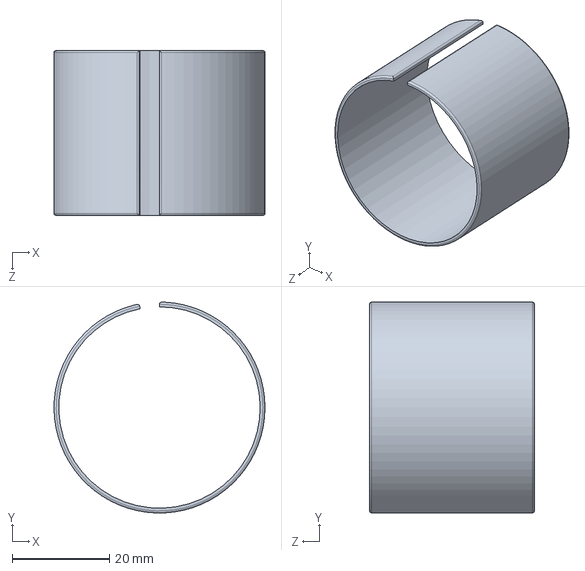
[picture p55: CAD file, 2019-03-22]
CAD/Parts/Gelung_motorDC.SLDPRT
43.5 x 43.5 x 34.0 mm
