andrewrichardr/MSE3380BGearBoxProject/CAD/AssemblyWithMotor/Shaft_C.SLDPRT

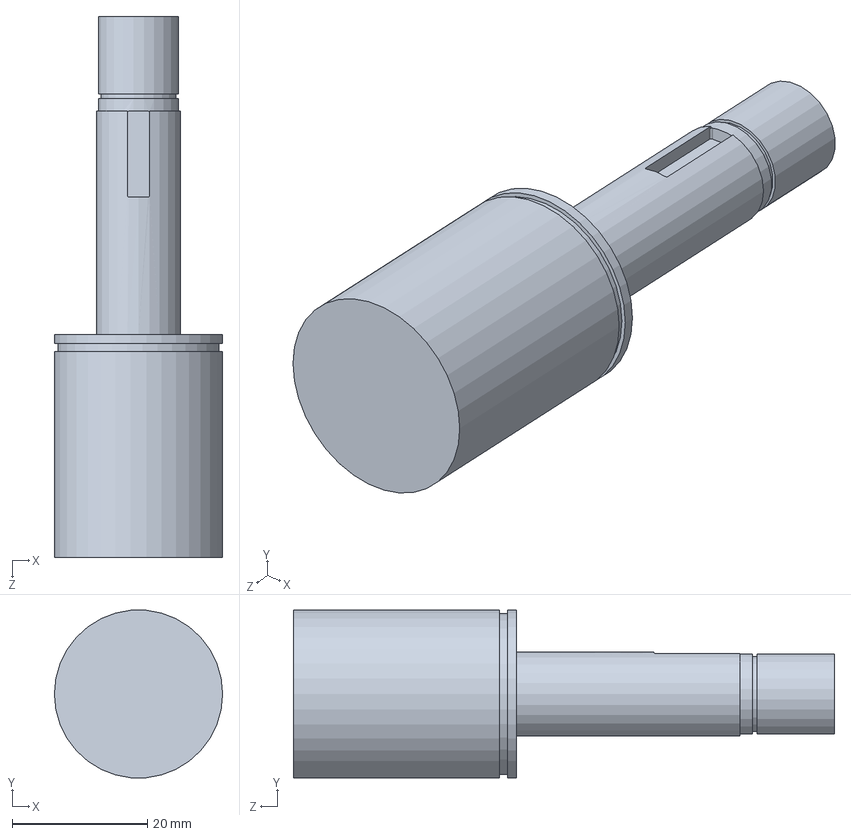
[picture p56: CAD file, 2019-04-09]
CAD/AssemblyWithMotor/Shaft_C.SLDPRT
24.9 x 24.8 x 80.0 mm
