andrewrichardr/MSE3380BGearBoxProject/CAD/Parts/Gear.SLDPRT

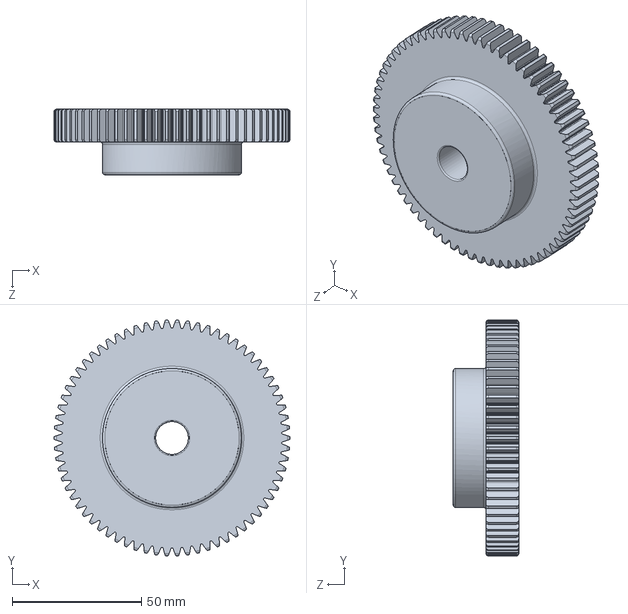
[picture p57: CAD file, 2019-03-22]
CAD/Parts/Gear.SLDPRT
91.4 x 91.4 x 25.4 mm
