andrewrichardr/MSE3380BGearBoxProject/CAD/Parts/Gear_Shaft.SLDPRT

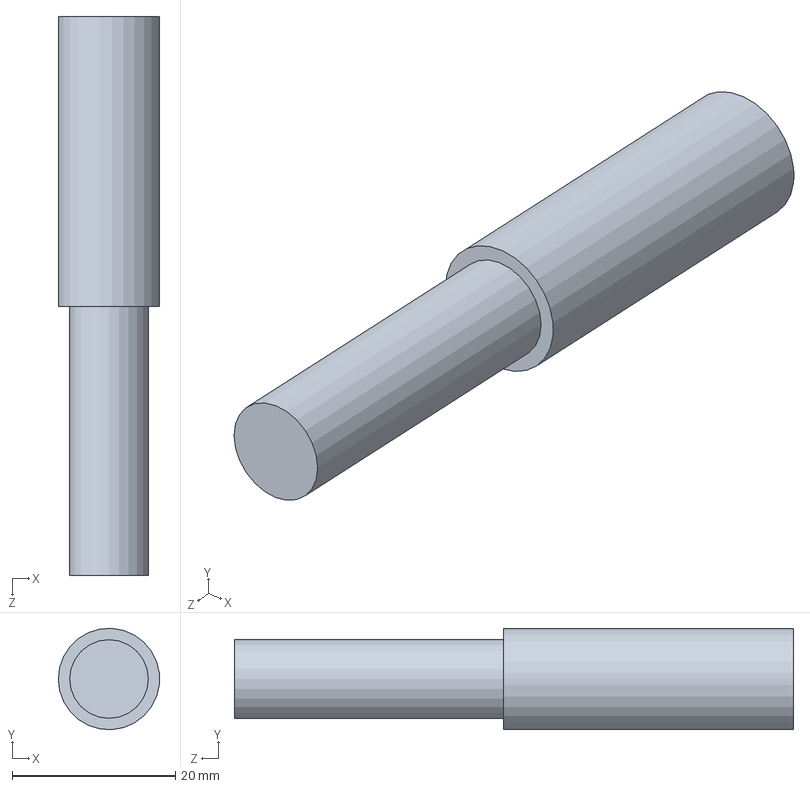
[picture p59: CAD file, 2019-03-22]
CAD/Parts/Gear_Shaft.SLDPRT
12.4 x 12.4 x 68.6 mm
