andrewrichardr/MSE3380BGearBoxProject/CAD/Final_Assembly/Collar 1in Shaft.SLDPRT

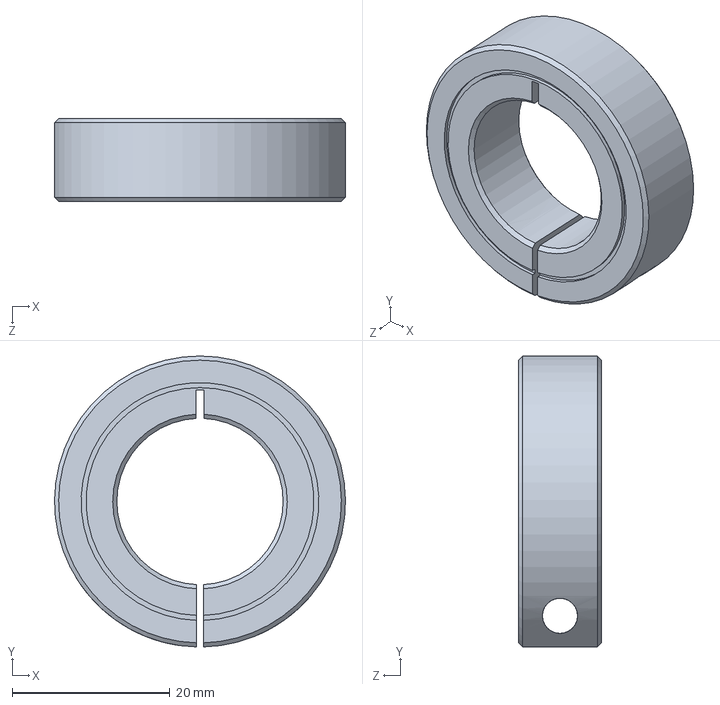
[picture p60: CAD file, 2019-04-09]
CAD/Final_Assembly/Collar 1in Shaft.SLDPRT
36.9 x 36.9 x 10.5 mm
