andrewrichardr/MSE3380BGearBoxProject/CAD/Parts/Wessel_motorDC.SLDPRT

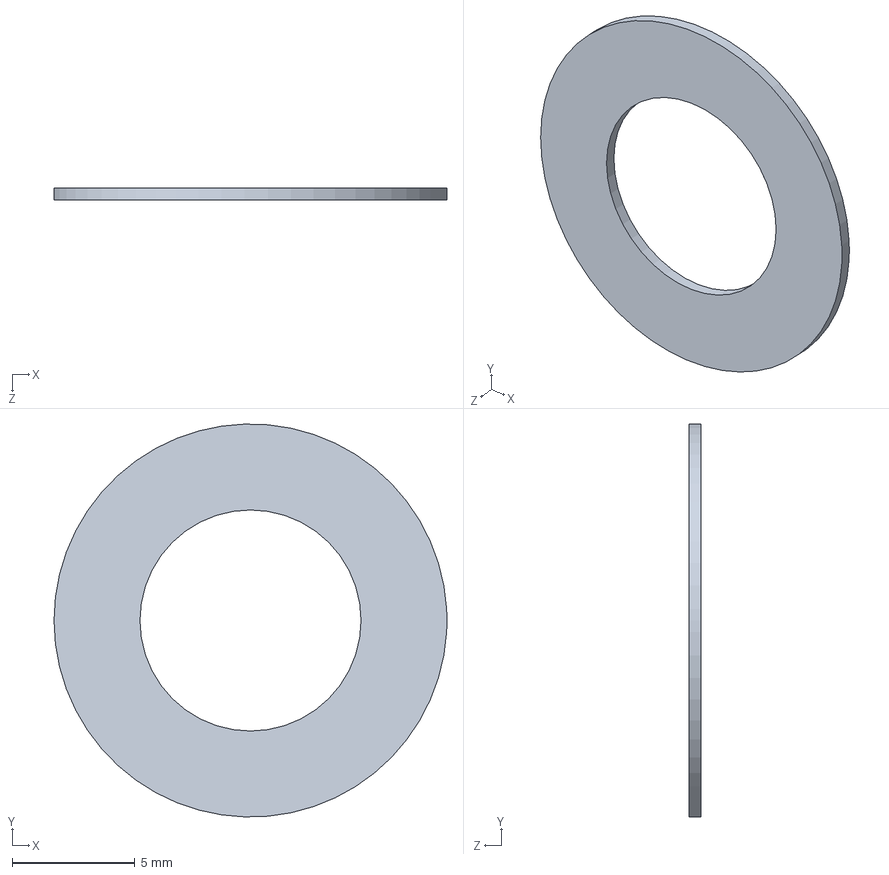
[picture p61: CAD file, 2019-03-22]
CAD/Parts/Wessel_motorDC.SLDPRT
16.0 x 16.0 x 0.5 mm
