andrewrichardr/MSE3380BGearBoxProject/CAD/Parts/Chuck.SLDPRT

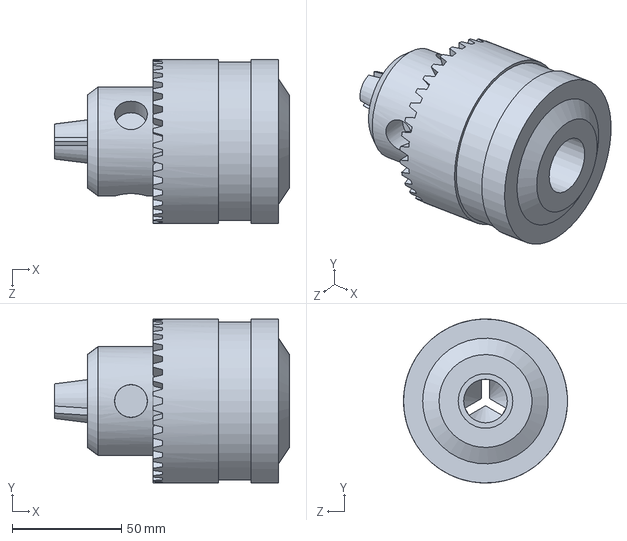
[picture p62: CAD file, 2019-03-22]
CAD/Parts/Chuck.SLDPRT
107.5 x 75.0 x 75.0 mm
