andrewrichardr/MSE3380BGearBoxProject/CAD/Final_Assembly/Collar.SLDPRT

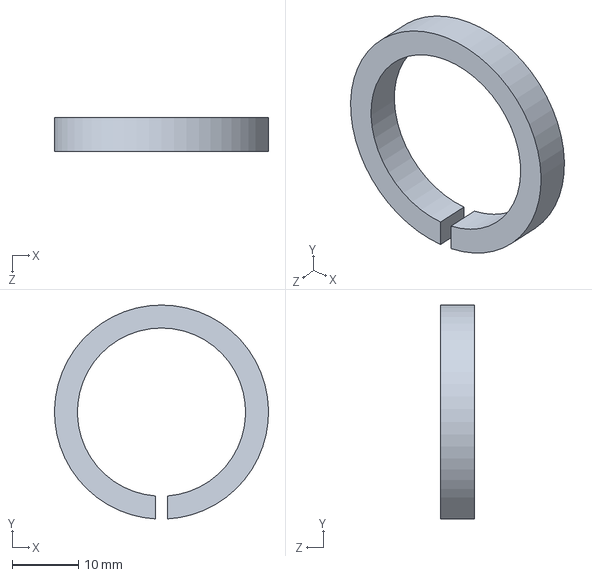
[picture p63: CAD file, 2019-04-09]
CAD/Final_Assembly/Collar.SLDPRT
32.3 x 32.3 x 5.08 mm
