andrewrichardr/MSE3380BGearBoxProject/CAD/Parts/Shaft_motorDC.SLDPRT

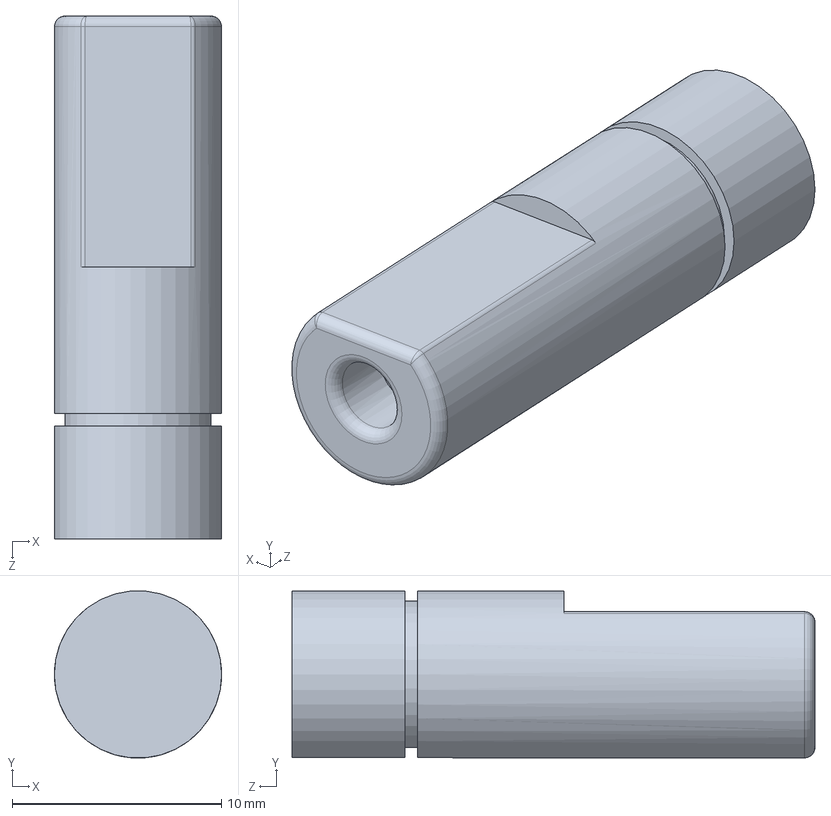
[picture p64: CAD file, 2019-03-22]
CAD/Parts/Shaft_motorDC.SLDPRT
8.00 x 7.97 x 25.0 mm
