andrewrichardr/MSE3380BGearBoxProject/CAD/AssemblyWithMotor/Gear_Shaft.SLDPRT

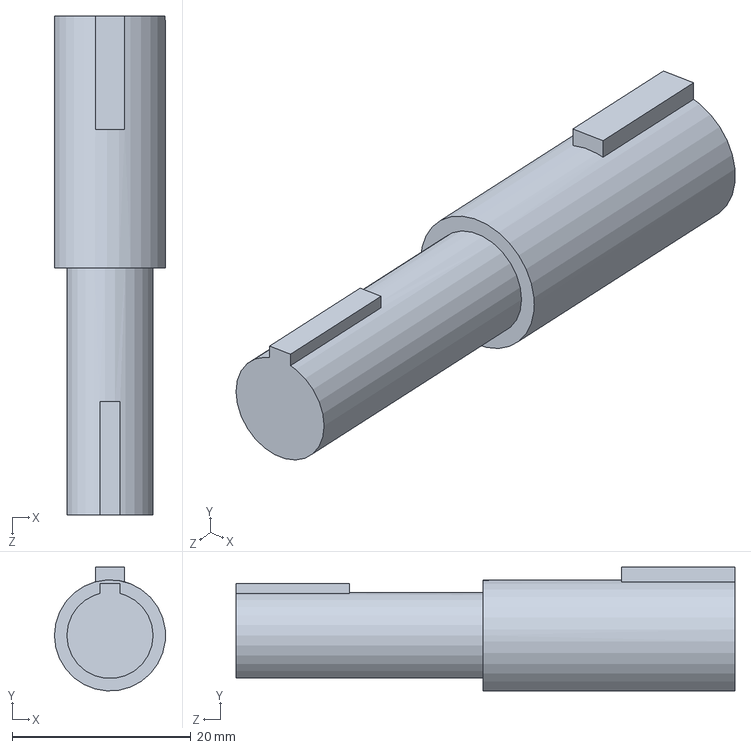
[picture p65: CAD file, 2019-04-09]
CAD/AssemblyWithMotor/Gear_Shaft.SLDPRT
12.4 x 13.9 x 55.9 mm
