andrewrichardr/MSE3380BGearBoxProject/CAD/Parts/Coil_motorDC.SLDPRT

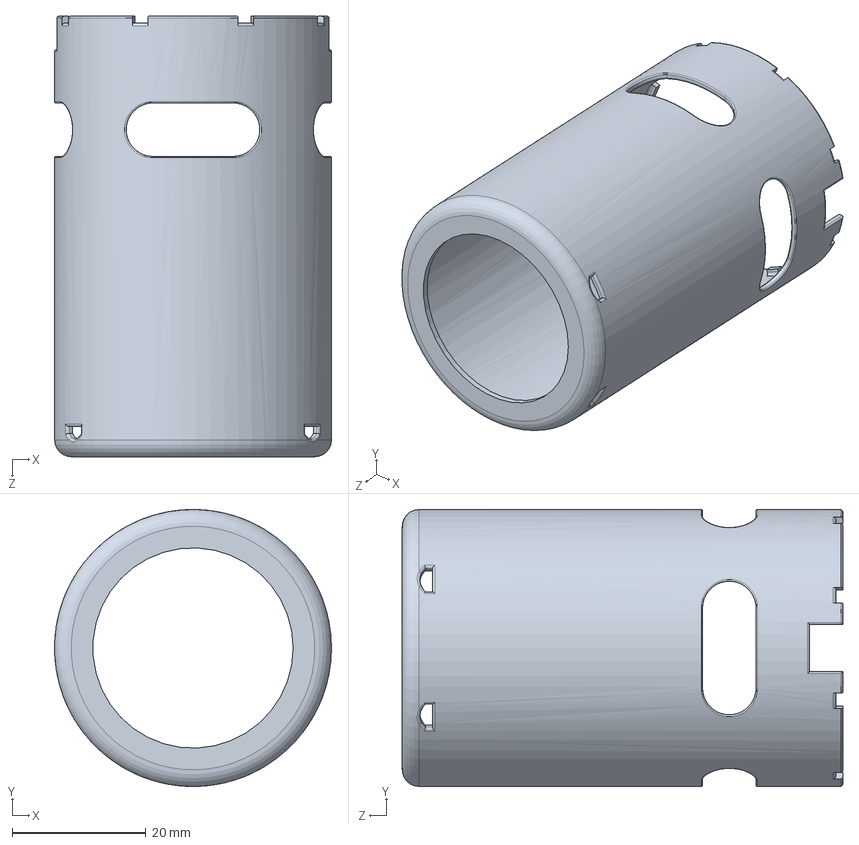
[picture p66: CAD file, 2019-03-22]
CAD/Parts/Coil_motorDC.SLDPRT
41.5 x 41.5 x 66.0 mm
