andrewrichardr/MSE3380BGearBoxProject/CAD/AssemblyWithMotor/Pinion_Shaft.SLDPRT

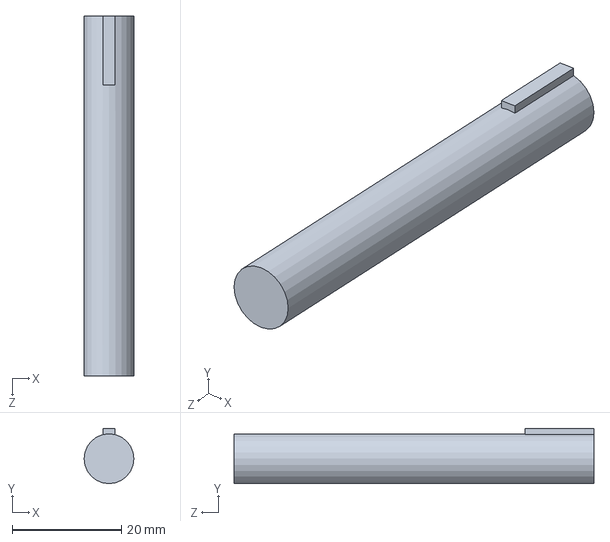
[picture p67: CAD file, 2019-04-09]
CAD/AssemblyWithMotor/Pinion_Shaft.SLDPRT
9.14 x 10.1 x 66.0 mm
