andrewrichardr/MSE3380BGearBoxProject/CAD/Parts/Bracket_motorDC.SLDPRT

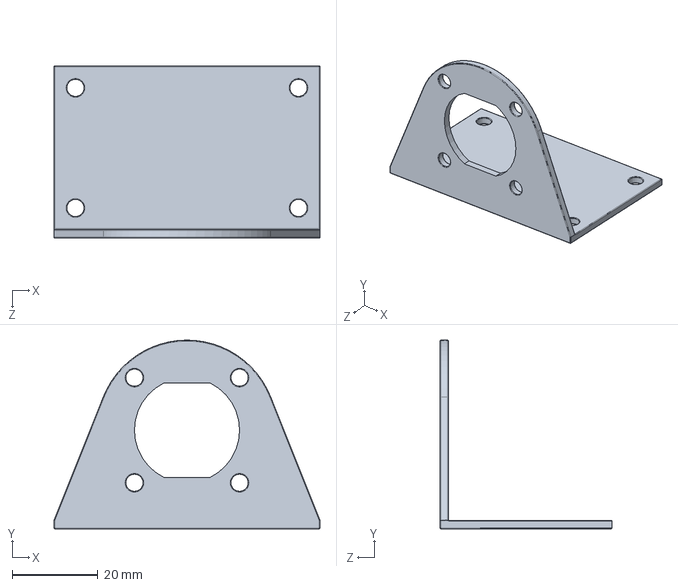
[picture p68: CAD file, 2019-03-22]
CAD/Parts/Bracket_motorDC.SLDPRT
62.0 x 44.0 x 40.1 mm
