andrewrichardr/MSE3380BGearBoxProject/CAD/AssemblyWithMotor/bearingshaft3.SLDPRT

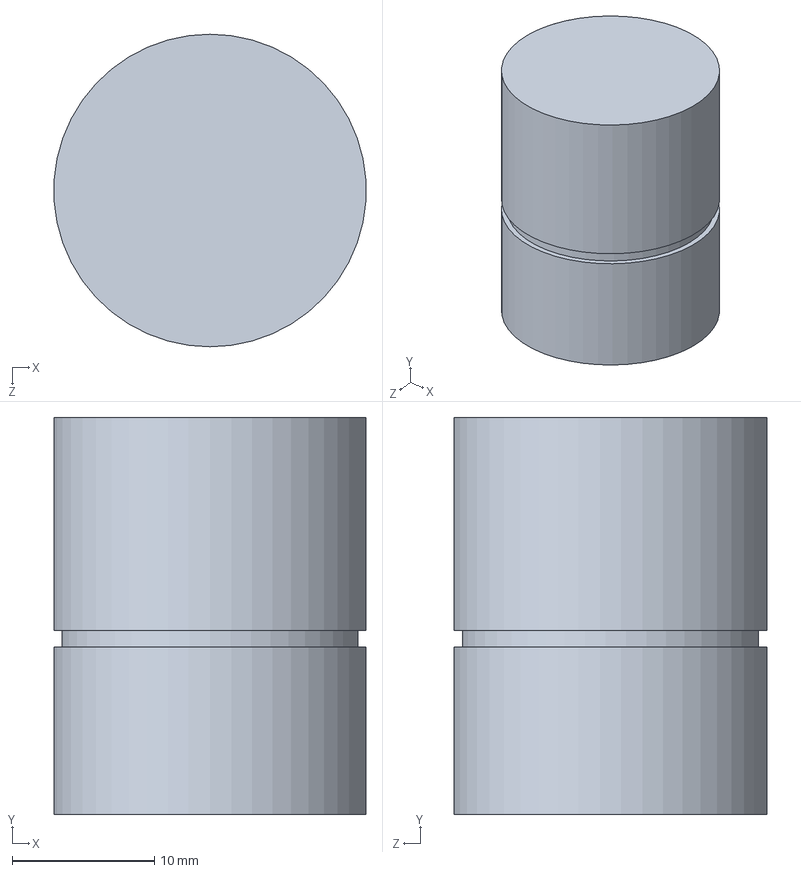
[picture p69: CAD file, 2019-04-09]
CAD/AssemblyWithMotor/bearingshaft3.SLDPRT
21.9 x 27.9 x 22.0 mm
