andrewrichardr/MSE3380BGearBoxProject/CAD/AssemblyWithMotor/bearingshaft1.SLDPRT

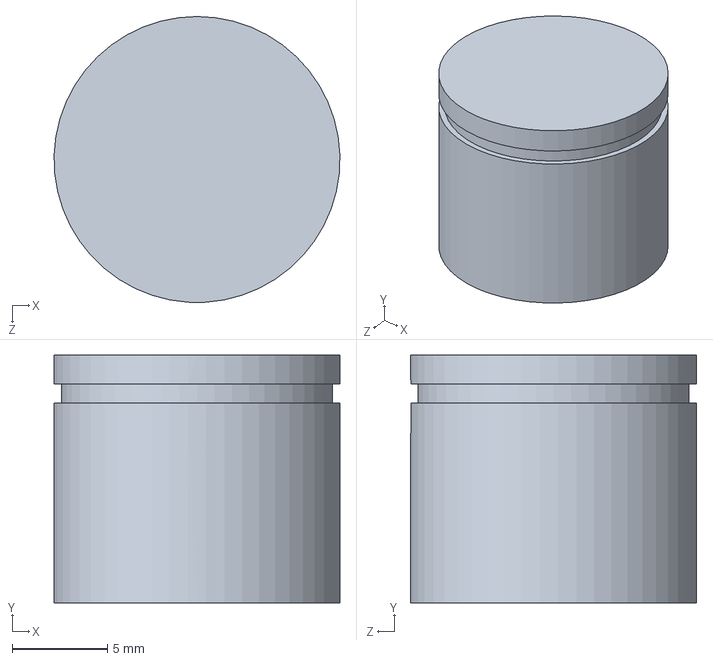
[picture p70: CAD file, 2019-04-09]
CAD/AssemblyWithMotor/bearingshaft1.SLDPRT
15.0 x 13.0 x 15.0 mm
