andrewrichardr/MSE3380BGearBoxProject/CAD/Parts/GearBox_motorDC.SLDPRT

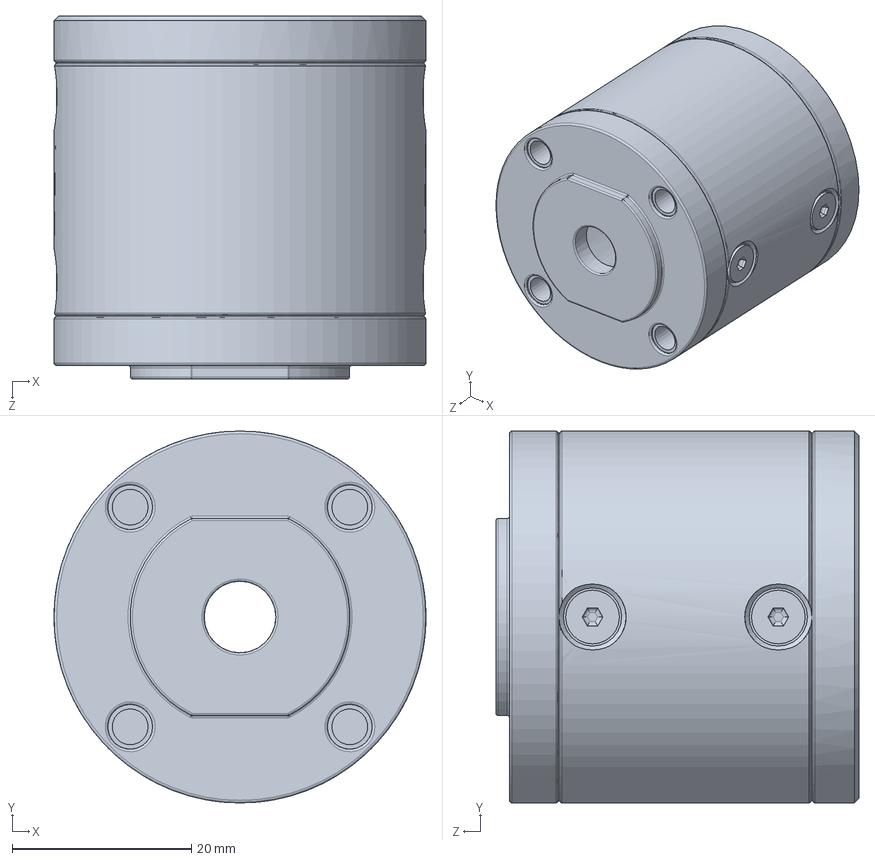
[picture p71: CAD file, 2019-03-22]
CAD/Parts/GearBox_motorDC.SLDPRT
41.5 x 41.5 x 40.5 mm
