andrewrichardr/MSE3380BGearBoxProject/CAD/AssemblyWithMotor/bearingshaft2.SLDPRT

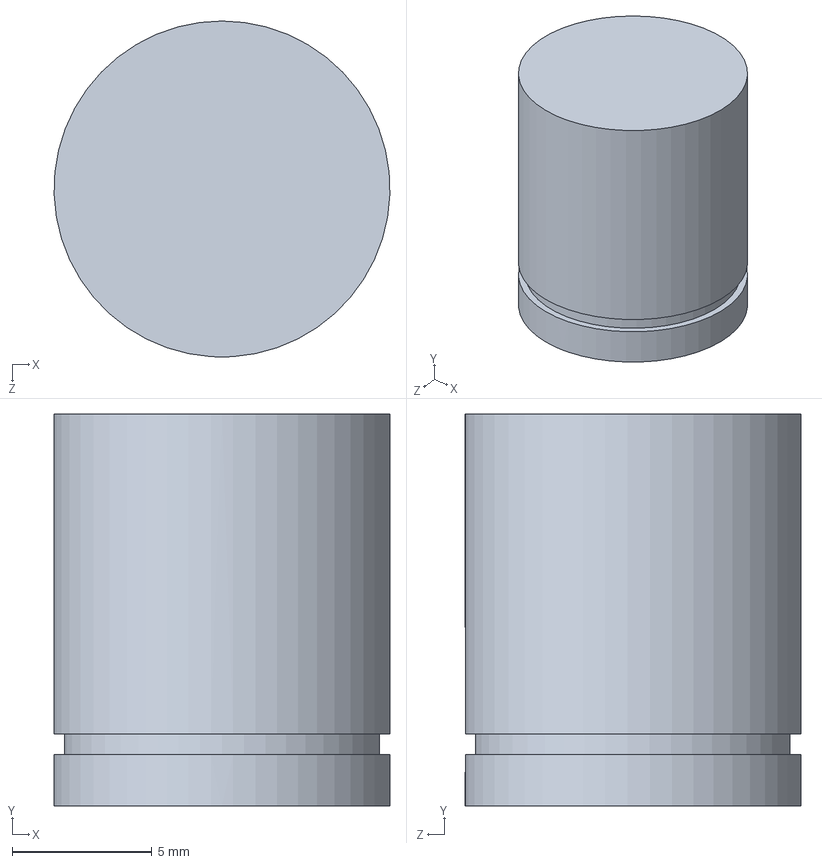
[picture p72: CAD file, 2019-04-09]
CAD/AssemblyWithMotor/bearingshaft2.SLDPRT
12.0 x 14.0 x 12.0 mm
