andrewrichardr/MSE3380BGearBoxProject/CAD/Final_Assembly/keyway_C.SLDPRT

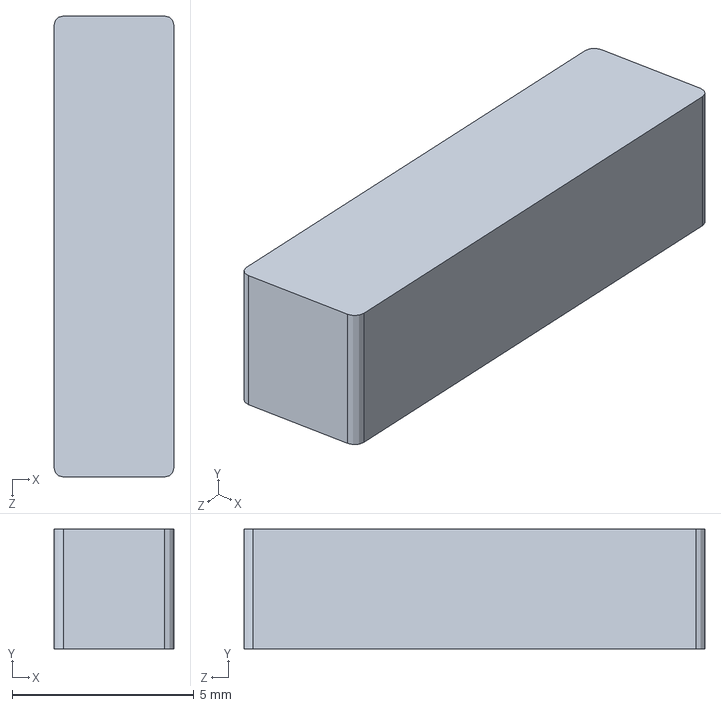
[picture p73: CAD file, 2019-04-09]
CAD/Final_Assembly/keyway_C.SLDPRT
3.30 x 3.30 x 12.7 mm
