andrewrichardr/MSE3380BGearBoxProject/CAD/AssemblyWithMotor/Chuck_Shaft.SLDPRT

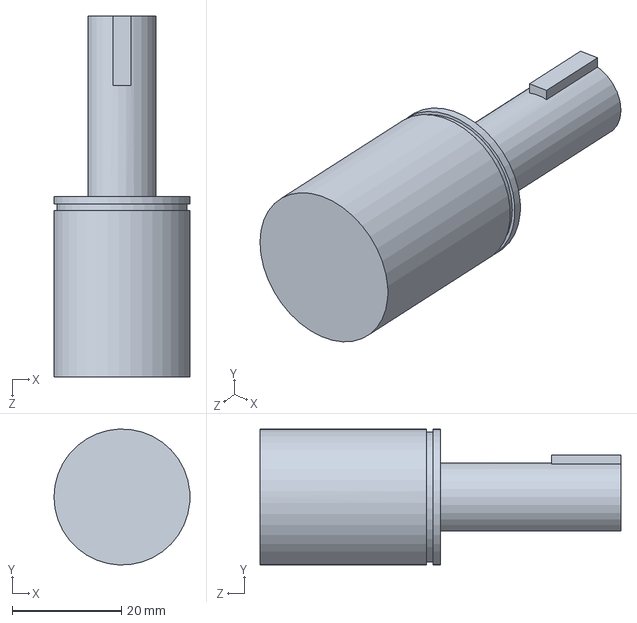
[picture p74: CAD file, 2019-04-09]
CAD/AssemblyWithMotor/Chuck_Shaft.SLDPRT
24.9 x 24.9 x 66.0 mm
