andrewrichardr/MSE3380BGearBoxProject/CAD/Final_Assembly/keyway_A.SLDPRT

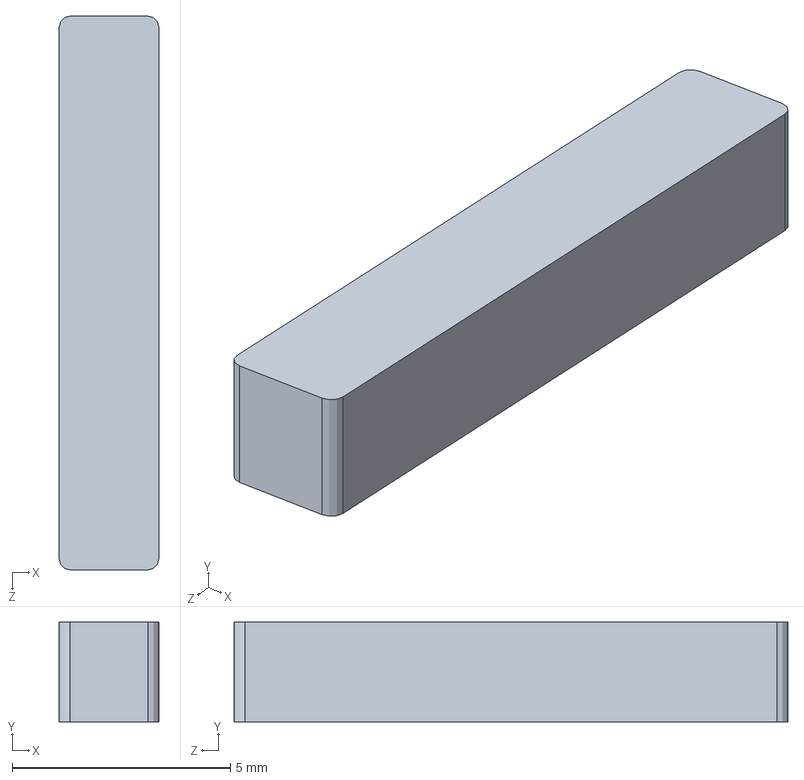
[picture p75: CAD file, 2019-04-09]
CAD/Final_Assembly/keyway_A.SLDPRT
2.29 x 2.29 x 12.7 mm
