andrewrichardr/MSE3380BGearBoxProject/CAD/Final_Assembly/motorDC.SLDPRT

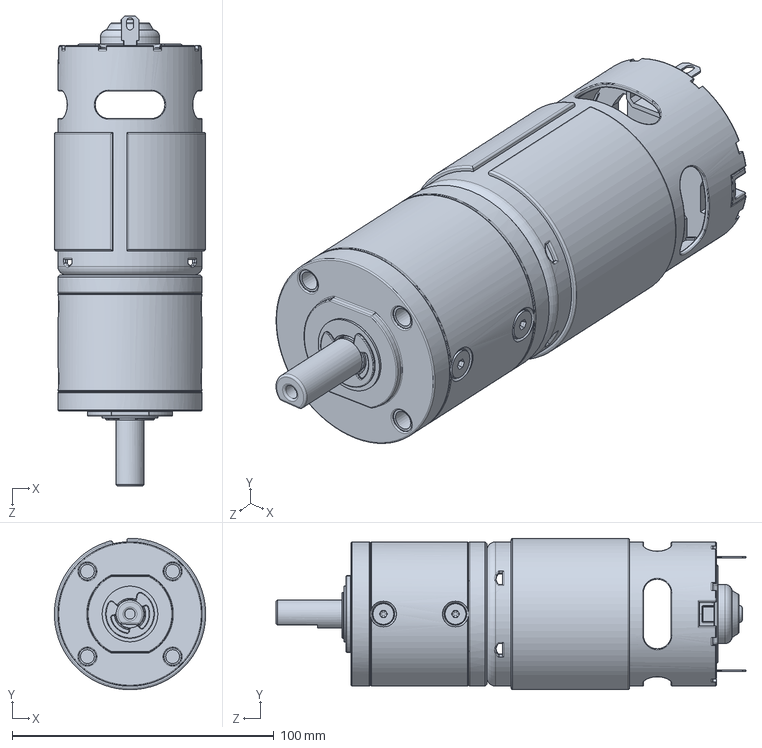
[picture p76: CAD file, 2019-04-09]
CAD/Final_Assembly/motorDC.SLDPRT
57.8 x 57.9 x 179.7 mm
