andrewrichardr/MSE3380BGearBoxProject/(list of files, cad)

Other CAD files:
CAD/Final_Assembly/6301.sldasm
CAD/Final_Assembly/63_22.sldasm
CAD/Final_Assembly/AssemblyWithMotor.SLDASM
CAD/Final_Assembly/6202_2RSL.sldasm
CAD/AssemblyWithMotor/63_22.sldasm
CAD/AssemblyWithMotor/6202_2RSL.sldasm
CAD/AssemblyWithMotor/NEWRING.SLDPRT
CAD/AssemblyWithMotor/Bearing2.SLDPRT
CAD/AssemblyWithMotor/shaft_A.SLDPRT
CAD/Final_Assembly/shaft_B.SLDPRT
CAD/AssemblyWithMotor/housing.SLDPRT
CAD/Final_Assembly/Gear.SLDPRT
CAD/Final_Assembly/bearing4.SLDPRT
CAD/Final_Assembly/Bearing13.SLDPRT
CAD/Final_Assembly/keyway_B2.SLDPRT
CAD/Final_Assembly/keyway_B1.SLDPRT
CAD/Final_Assembly/_6202_2RSL_PART3_6.sldprt
CAD/Final_Assembly/_61805_PART1_2.sldprt
CAD/Final_Assembly/_6202_2RSL_PART1_2.sldprt
CAD/Final_Assembly/Chuck.SLDPRT
CAD/Final_Assembly/_6202_2RSL_PART2_4.sldprt
CAD/Final_Assembly/_61805_PART2_4.sldprt
CAD/Final_Assembly/_6301_PART3_6.sldprt
CAD/Final_Assembly/Pinion.SLDPRT
CAD/Final_Assembly/_63_22_PART3_6.sldprt
CAD/Final_Assembly/bearingshaft4.SLDPRT
CAD/Final_Assembly/_63_22_PART1_2.sldprt
CAD/Final_Assembly/_63_22_PART2_4.sldprt
CAD/Final_Assembly/_61805_PART3_6.sldprt
CAD/Final_Assembly/_6301_PART2_4.sldprt
CAD/Final_Assembly/_6301_PART1_2.sldprt
CAD/AssemblyWithMotor/61805.sldasm
CAD/CrossSection.SLDDRW
CAD/Final_Assembly/1095K650_STEEL GREASE FITTING.SLDPRT
CAD/Final_Assembly/61805.sldasm
CAD/Part Drawings/Gear2_Final.SLDDRW
CAD/Part Drawings/Gear_Final.SLDDRW
CAD/Part Drawings/Gear_Final_Metric.SLDDRW
CAD/Part Drawings/Old/Shaft_C.SLDDRW
CAD/Part Drawings/Old/shaft_A.SLDDRW
CAD/Part Drawings/Old/shaft_B.SLDDRW
CAD/Part Drawings/Pinion_Final.SLDDRW
CAD/Part Drawings/Pinion_Final_metric.SLDDRW
CAD/Part Drawings/Shaft_C.SLDDRW
CAD/Part Drawings/shaft_A.SLDDRW
CAD/Part Drawings/shaft_B.SLDDRW
CAD/Parts/Gear.SLDDRW
CAD/Parts/Pinion.SLDDRW
