andrewrichardr/MSE3380BGearBoxProject/CAD/Parts/Gear.PDF

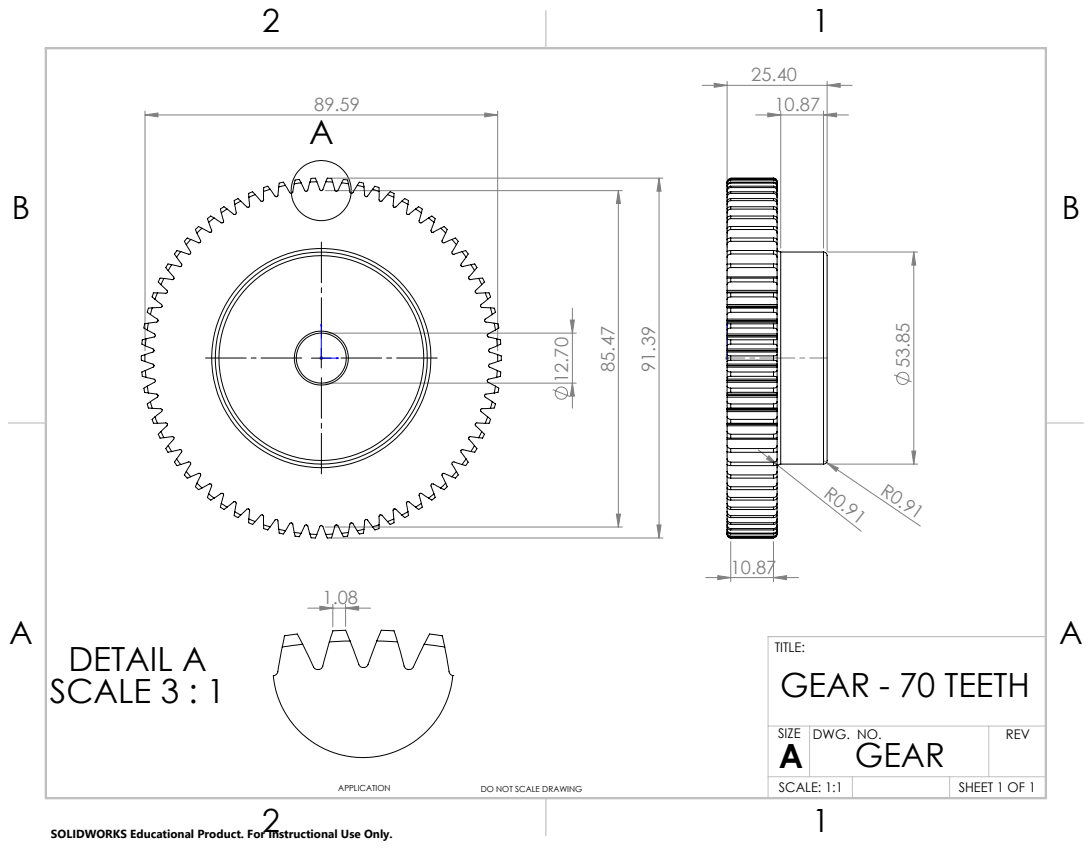
[picture p77: page 1]
DETAIL A SCALE 3 : 1; DO NOT SCALE DRAWING; SCALE: 1:1; GEAR - 70 TEETH

SIZE A | DWG. NO. GEAR | REV

SHEET 1 OF 1

SOLIDWORKS Educational Product. For Instructional Use Only.
