andrewrichardr/MSE3380BGearBoxProject/html/main_01-eps-converted-to.pdf

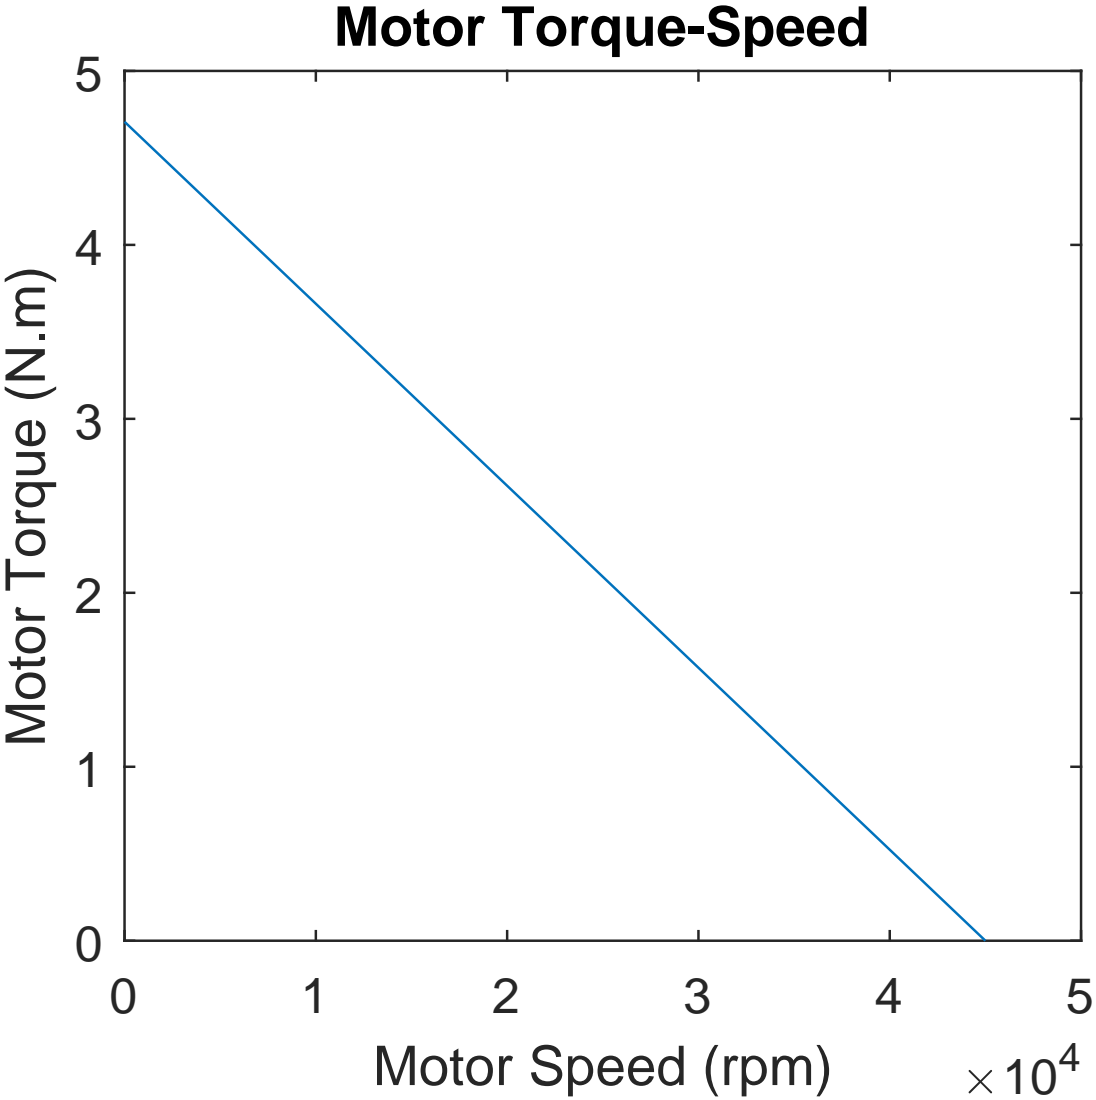
[picture p78: page 1]
Motor Speed (rpm); Motor Torque (N.m)

Motor Torque-Speed
