andrewrichardr/MSE3380BGearBoxProject/html/main_02-eps-converted-to.pdf

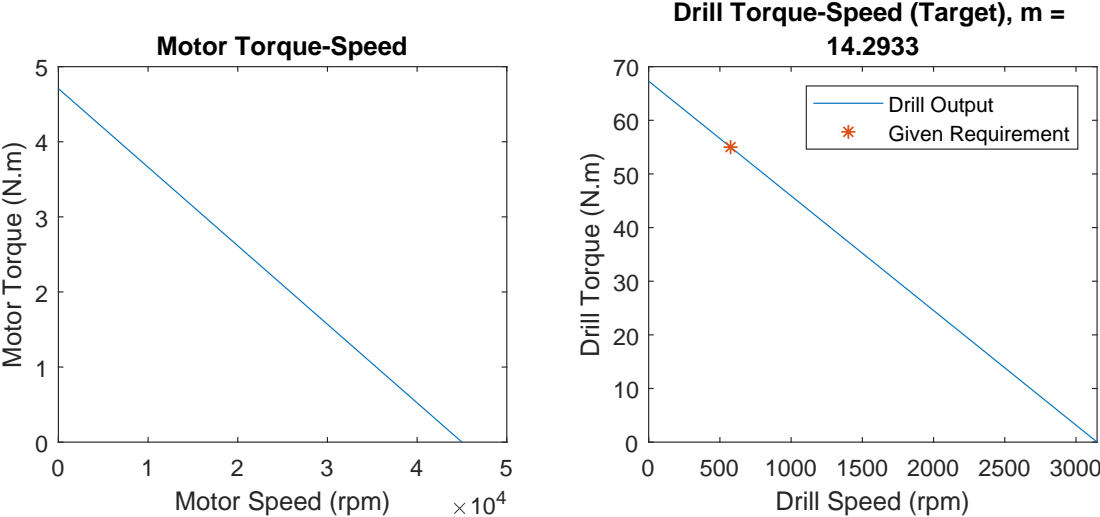
[picture p79: page 1]
Motor Speed (rpm); Motor Torque (N.m); Drill Torque (N.m); Drill Output Given Requirement

Drill Torque-Speed (Target), m =

Motor Torque-Speed

Drill Speed (rpm)
