andrewrichardr/MSE3380BGearBoxProject/html/main_04-eps-converted-to.pdf

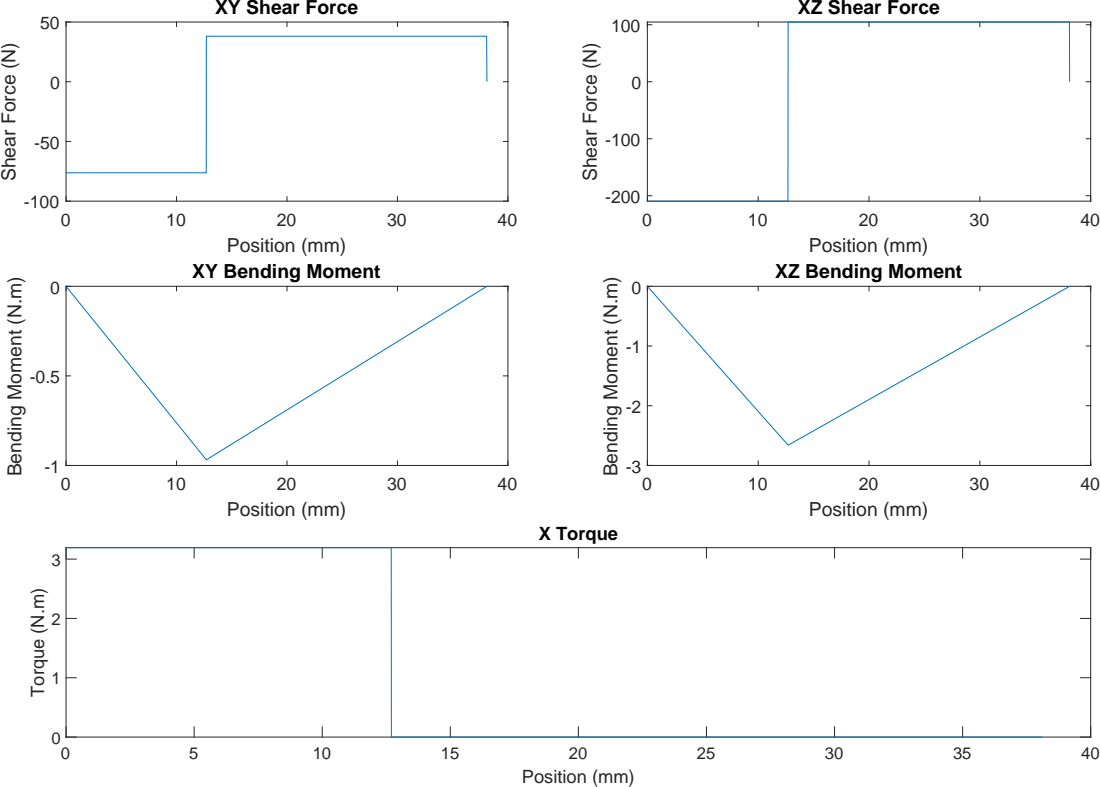
[picture p80: page 1]
Shear Force (N); Position (mm); Bending Moment (N.m); Torque (N.m); X Torque

XY Shear Force

XZ Shear Force

Position (mm)
XY Bending Moment

XZ Bending Moment
