andrewrichardr/MSE3380BGearBoxProject/CAD/Part Drawings/shaft_B.PDF

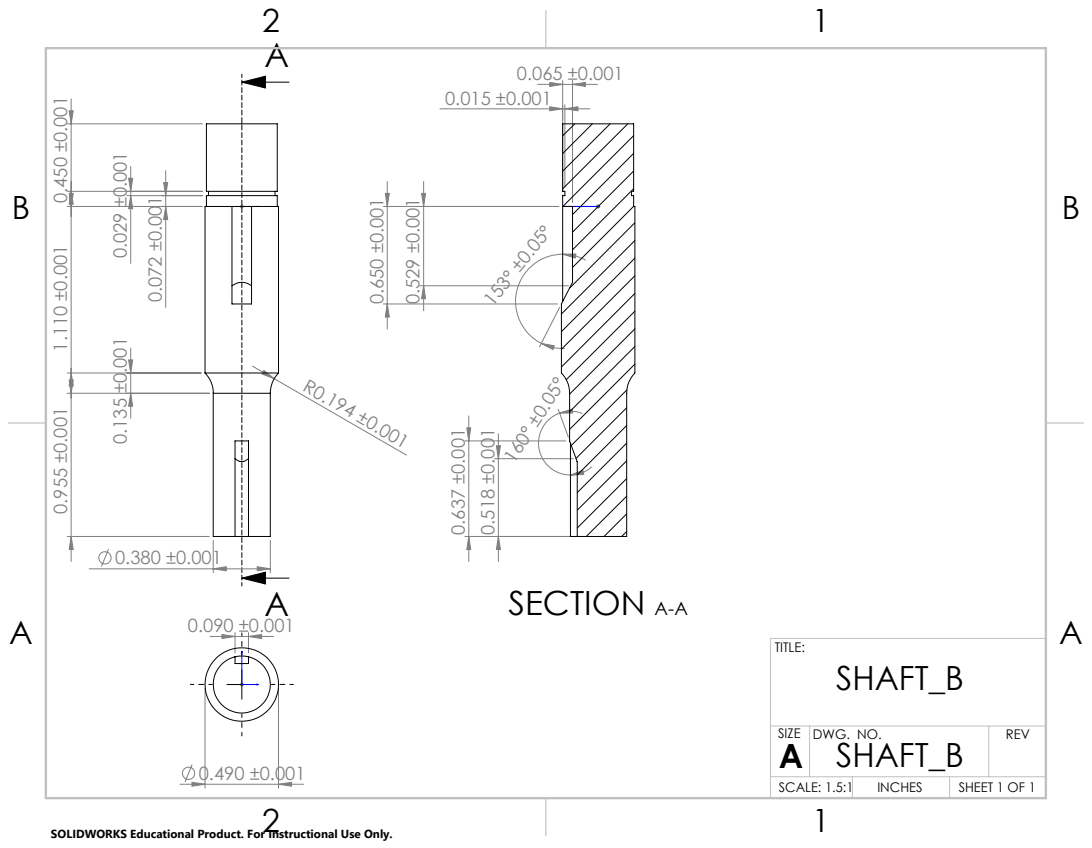
[picture p82: page 1]
SECTION A-A

SIZE A | DWG. NO. SHAFT_B | REV

SCALE: 1.5:1 | INCHES | SHEET 1 OF 1

SOLIDWORKS Educational Product. For Instructional Use Only.
