andrewrichardr/MSE3380BGearBoxProject/CAD/Part Drawings/Gear_Final.PDF

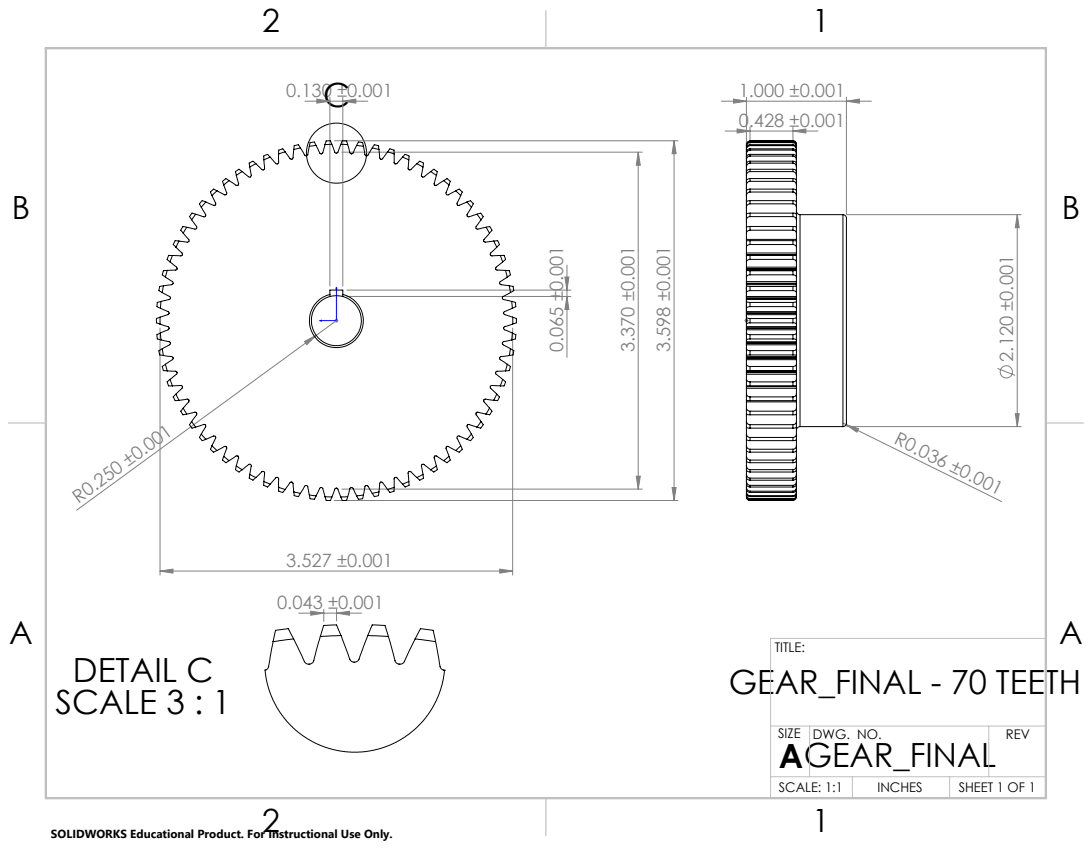
[picture p84: page 1]
DETAIL C SCALE 3 : 1; GEAR_FINAL - 70 TEETH

SIZE A GEAR_FINAL | DWG. NO. | REV

SCALE: 1:1 | INCHES | SHEET 1 OF 1

SOLIDWORKS Educational Product. For Instructional Use Only.
