andrewrichardr/MSE3380BGearBoxProject/CAD/Parts/Pinion.PDF

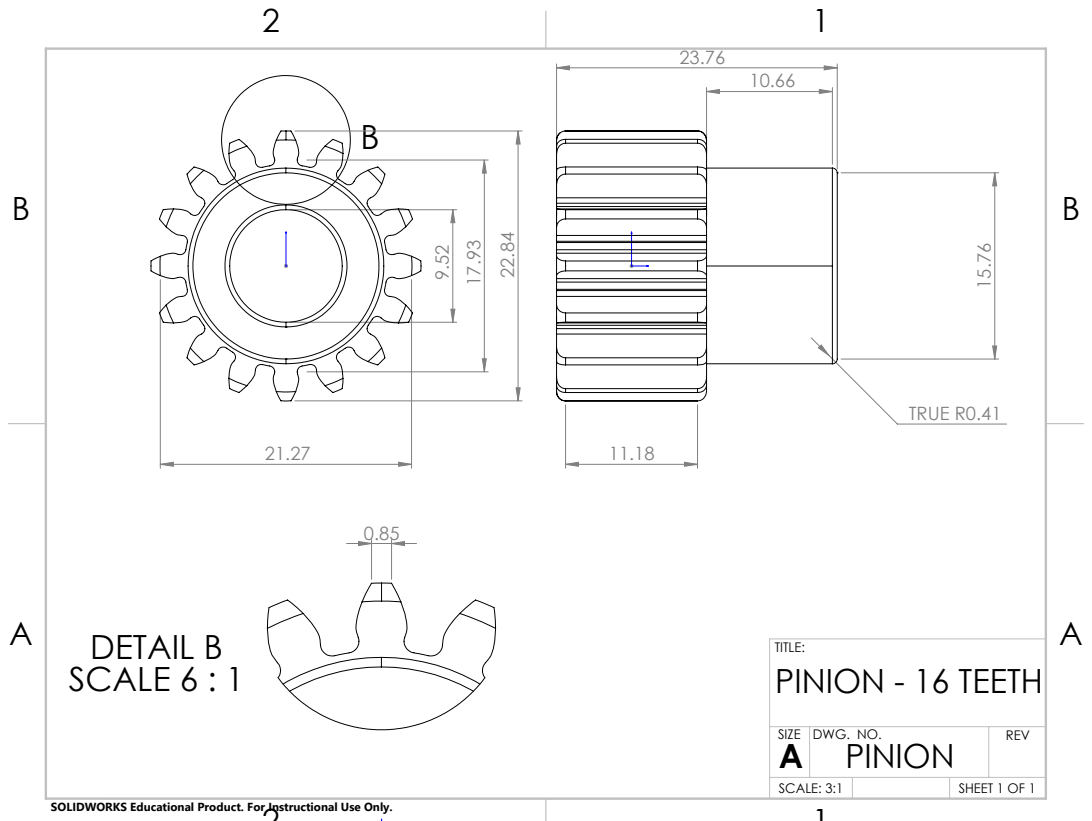
[picture p85: page 1]
TRUE R0.41; DETAIL B SCALE 6 : 1; PINION - 16 TEETH

SIZE A | DWG. NO. PINION | REV

SCALE: 3:1 | | SHEET 1 OF 1

SOLIDWORKS Educational Product. For Instructional Use Only.
