andrewrichardr/MSE3380BGearBoxProject/CAD/Part Drawings/Pinion_Final.PDF

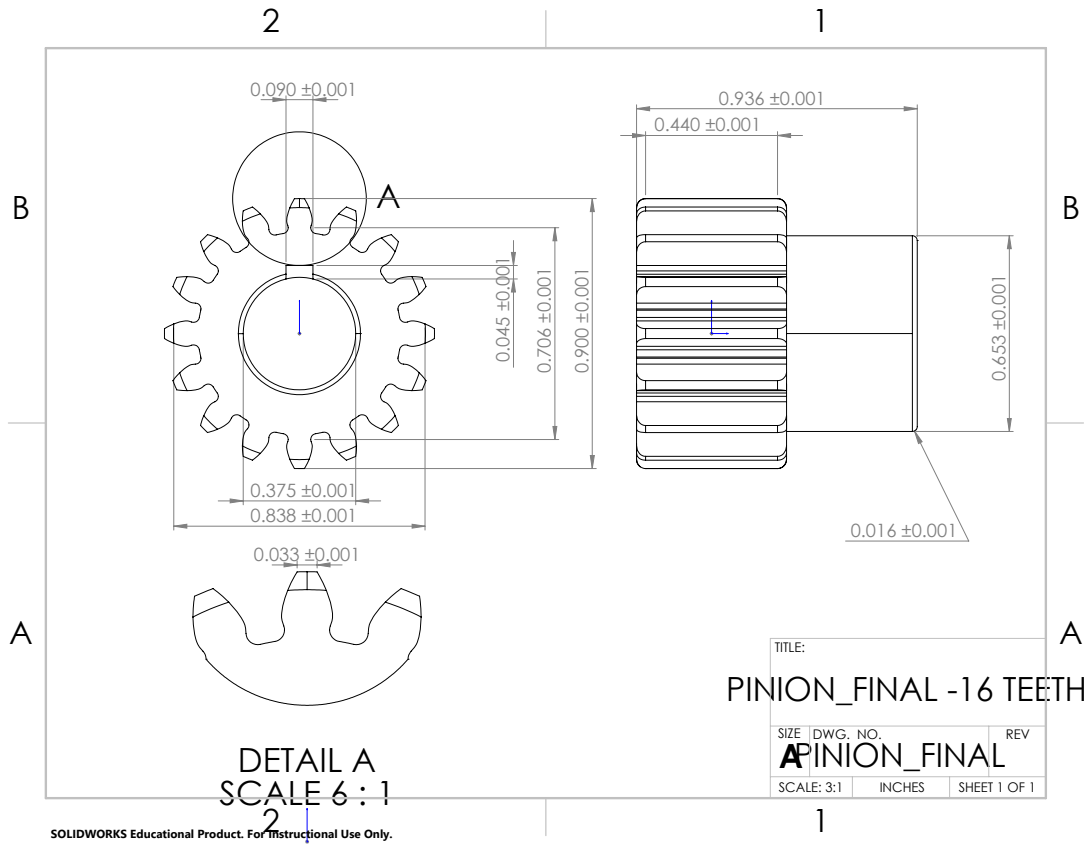
[picture p86: page 1]
DETAIL A SCALE 6 : 1; PINION_FINAL -16 TEETH

SIZE A PINION_FINAL | DWG. NO. | REV

SCALE: 3:1 | INCHES | SHEET 1 OF 1

SOLIDWORKS Educational Product. For Instructional Use Only.
