andrewrichardr/MSE3380BGearBoxProject/(commit log)

2019-03-17 Stage Ratios Specified
2019-03-20 contact and bending
    [Tables.xlsx]
2019-03-21 Created Folders for CAD and Figures
2019-03-21 Extracted 3D models from .zip
    [70 teeth.SLDPRT, 70.SLDPRT, WOrek.SLDASM, YA16.SLDPRT, ta16.SLDPRT]
2019-03-22 Extracted newest version of gearbox assembly
    [70 teeth.SLDPRT, 70.SLDPRT, Bracket_motorDC.SLDPRT, Brush_motorDC.SLDPRT, Chuck.SLDPRT, Coil_motorDC.SLDPRT, GearBox_motorDC.SLDPRT, Gelung_motorDC.SLDPRT]
2019-03-22 Moved render of assembly to figures folder
2019-03-22 added 2D pressure angle FBD
2019-03-22 fos fixed
    [Tables.xlsx]
2019-03-22 added FBD of 2nd pinion and 2nd gear
2019-03-22 fbd of output gear and pinion added
2019-03-22 organized files
    [Bracket_motorDC.SLDPRT, Brush_motorDC.SLDPRT, Chuck.SLDPRT, Chuck_Shaft.SLDPRT, Coil_motorDC.SLDPRT, Gear.SLDPRT, GearBox_motorDC.SLDPRT, Gear_Shaft.SLDPRT]
2019-03-22 Added gear drawing
    [Gear_70teeth.SLDDRW]
2019-03-22 Added part drawings for gears
    [Gear.SLDDRW, Pinion.SLDDRW]
2019-03-22 Added part drawings
    [Pinion.SLDDRW]
2019-03-22 added non-3D report
    [Tables.xlsx]
2019-04-01 Torque and force calculation added
2019-04-03 Shear, Moment, and Torque Diagrams Added
2019-04-04 Fatigue FOS interim
    [Tables.xlsx]
2019-04-09 added unzipped gearbox assembly
    [61805.sldasm, 6202_2RSL.sldasm, 6301.sldasm, 63_22.sldasm, AssemblyWithMotor.SLDASM, Bearing13.SLDPRT, Bearing2.SLDPRT, Chuck.SLDPRT]
2019-04-09 Added latest version of gearbox assembly
    [1095K650_STEEL GREASE FITTING.SLDPRT, 61805.sldasm, 6202_2RSL.sldasm, 6301.sldasm, 63_22.sldasm, AssemblyWithMotor.SLDASM, Bearing13.SLDPRT, Bearing2.SLDPRT]
2019-04-09 Added shafts with fixed keyways and keys
    [Shaft_C.SLDPRT, keyway_A.SLDPRT, keyway_B1.SLDPRT, keyway_B2.SLDPRT, keyway_C.SLDPRT, shaft_A.SLDPRT, shaft_B.SLDPRT]
2019-04-09 Added latest assembly with fixed shafts/keyways
    [AssemblyWithMotor.SLDASM, Bearing13.SLDPRT, Bearing2.SLDPRT, Gear.SLDPRT, NEWRING.SLDPRT, bearing4.SLDPRT]
2019-04-09 Added part drawings, interactive 3D model, and start of shaft FBD's
    [AssemblyWithMotor.SLDASM, Gear_Final.SLDDRW, Gear_Final_Metric.SLDDRW, Pinion_Final.SLDDRW, Pinion_Final_metric.SLDDRW, Shaft_C.SLDDRW, shaft_A.SLDDRW, shaft_B.SLDDRW]
2019-04-09 Added final assembly of gearbox
    [6301.sldasm, AssemblyWithMotor.SLDASM]
2019-04-09 Added FBD's and torque diagrams
    [Gear2_Final.SLDDRW, Shaft_C.SLDDRW, shaft_A.SLDDRW, shaft_B.SLDDRW]
2019-04-09 Added final assembly, interactive 3D model, shaft part drawings, and FBD Diagrams
    [1095K650_STEEL GREASE FITTING.SLDPRT, 61805.sldasm, 6202_2RSL.sldasm, 6301.sldasm, 63_22.sldasm, AssemblyWithMotor.SLDASM, Bearing13.SLDPRT, Chuck.SLDPRT]
